Orgo2/insuDose/code/epaper_disp/OBJ/OLED.htm

# Static Call Graph for image ..\OBJ\OLED.axf

#<CALLGRAPH># ARM Linker, 5.03 [Build 76]: Last Updated: Fri May 08 14:31:21 2020

### Maximum Stack Usage = 680 bytes + Unknown(Functions without stacksize, Cycles, Untraceable Function Pointers)

### Call chain for Maximum Stack Depth:

__rt_entry_main ⇒ main ⇒ Paint_DrawNum ⇒ Paint_DrawString_EN ⇒ Paint_DrawChar ⇒ Paint_SetPixel

### Functions with no stack information

- __user_initial_stackheap

### Mutually Recursive functions

- ADC1_2_IRQHandler ⇒ ADC1_2_IRQHandler

### Function Pointers

- ADC1_2_IRQHandler from startup_stm32f10x_hd.o(.text) referenced from startup_stm32f10x_hd.o(RESET)
- ADC3_IRQHandler from startup_stm32f10x_hd.o(.text) referenced from startup_stm32f10x_hd.o(RESET)
- BusFault_Handler from stm32f10x_it.o(.text) referenced from startup_stm32f10x_hd.o(RESET)
- CAN1_RX1_IRQHandler from startup_stm32f10x_hd.o(.text) referenced from startup_stm32f10x_hd.o(RESET)
- CAN1_SCE_IRQHandler from startup_stm32f10x_hd.o(.text) referenced from startup_stm32f10x_hd.o(RESET)
- DMA1_Channel1_IRQHandler from startup_stm32f10x_hd.o(.text) referenced from startup_stm32f10x_hd.o(RESET)
- DMA1_Channel2_IRQHandler from startup_stm32f10x_hd.o(.text) referenced from startup_stm32f10x_hd.o(RESET)
- DMA1_Channel3_IRQHandler from startup_stm32f10x_hd.o(.text) referenced from startup_stm32f10x_hd.o(RESET)
- DMA1_Channel4_IRQHandler from startup_stm32f10x_hd.o(.text) referenced from startup_stm32f10x_hd.o(RESET)
- DMA1_Channel5_IRQHandler from startup_stm32f10x_hd.o(.text) referenced from startup_stm32f10x_hd.o(RESET)
- DMA1_Channel6_IRQHandler from startup_stm32f10x_hd.o(.text) referenced from startup_stm32f10x_hd.o(RESET)
- DMA1_Channel7_IRQHandler from startup_stm32f10x_hd.o(.text) referenced from startup_stm32f10x_hd.o(RESET)
- DMA2_Channel1_IRQHandler from startup_stm32f10x_hd.o(.text) referenced from startup_stm32f10x_hd.o(RESET)
- DMA2_Channel2_IRQHandler from startup_stm32f10x_hd.o(.text) referenced from startup_stm32f10x_hd.o(RESET)
- DMA2_Channel3_IRQHandler from startup_stm32f10x_hd.o(.text) referenced from startup_stm32f10x_hd.o(RESET)
- DMA2_Channel4_5_IRQHandler from startup_stm32f10x_hd.o(.text) referenced from startup_stm32f10x_hd.o(RESET)
- DebugMon_Handler from stm32f10x_it.o(.text) referenced from startup_stm32f10x_hd.o(RESET)
- EXTI0_IRQHandler from startup_stm32f10x_hd.o(.text) referenced from startup_stm32f10x_hd.o(RESET)
- EXTI15_10_IRQHandler from startup_stm32f10x_hd.o(.text) referenced from startup_stm32f10x_hd.o(RESET)
- EXTI1_IRQHandler from startup_stm32f10x_hd.o(.text) referenced from startup_stm32f10x_hd.o(RESET)
- EXTI2_IRQHandler from startup_stm32f10x_hd.o(.text) referenced from startup_stm32f10x_hd.o(RESET)
- EXTI3_IRQHandler from startup_stm32f10x_hd.o(.text) referenced from startup_stm32f10x_hd.o(RESET)
- EXTI4_IRQHandler from startup_stm32f10x_hd.o(.text) referenced from startup_stm32f10x_hd.o(RESET)
- EXTI9_5_IRQHandler from startup_stm32f10x_hd.o(.text) referenced from startup_stm32f10x_hd.o(RESET)
- FLASH_IRQHandler from startup_stm32f10x_hd.o(.text) referenced from startup_stm32f10x_hd.o(RESET)
- FSMC_IRQHandler from startup_stm32f10x_hd.o(.text) referenced from startup_stm32f10x_hd.o(RESET)
- HardFault_Handler from stm32f10x_it.o(.text) referenced from startup_stm32f10x_hd.o(RESET)
- I2C1_ER_IRQHandler from startup_stm32f10x_hd.o(.text) referenced from startup_stm32f10x_hd.o(RESET)
- I2C1_EV_IRQHandler from startup_stm32f10x_hd.o(.text) referenced from startup_stm32f10x_hd.o(RESET)
- I2C2_ER_IRQHandler from startup_stm32f10x_hd.o(.text) referenced from startup_stm32f10x_hd.o(RESET)
- I2C2_EV_IRQHandler from startup_stm32f10x_hd.o(.text) referenced from startup_stm32f10x_hd.o(RESET)
- MemManage_Handler from stm32f10x_it.o(.text) referenced from startup_stm32f10x_hd.o(RESET)
- NMI_Handler from stm32f10x_it.o(.text) referenced from startup_stm32f10x_hd.o(RESET)
- PVD_IRQHandler from startup_stm32f10x_hd.o(.text) referenced from startup_stm32f10x_hd.o(RESET)
- PendSV_Handler from stm32f10x_it.o(.text) referenced from startup_stm32f10x_hd.o(RESET)
- RCC_IRQHandler from startup_stm32f10x_hd.o(.text) referenced from startup_stm32f10x_hd.o(RESET)
- RTCAlarm_IRQHandler from startup_stm32f10x_hd.o(.text) referenced from startup_stm32f10x_hd.o(RESET)
- RTC_IRQHandler from startup_stm32f10x_hd.o(.text) referenced from startup_stm32f10x_hd.o(RESET)
- Reset_Handler from startup_stm32f10x_hd.o(.text) referenced from startup_stm32f10x_hd.o(RESET)
- SDIO_IRQHandler from startup_stm32f10x_hd.o(.text) referenced from startup_stm32f10x_hd.o(RESET)
- SPI1_IRQHandler from startup_stm32f10x_hd.o(.text) referenced from startup_stm32f10x_hd.o(RESET)
- SPI2_IRQHandler from startup_stm32f10x_hd.o(.text) referenced from startup_stm32f10x_hd.o(RESET)
- SPI3_IRQHandler from startup_stm32f10x_hd.o(.text) referenced from startup_stm32f10x_hd.o(RESET)
- SVC_Handler from stm32f10x_it.o(.text) referenced from startup_stm32f10x_hd.o(RESET)
- SysTick_Handler from stm32f10x_it.o(.text) referenced from startup_stm32f10x_hd.o(RESET)
- SystemInit from system_stm32f10x.o(.text) referenced from startup_stm32f10x_hd.o(.text)
- TAMPER_IRQHandler from startup_stm32f10x_hd.o(.text) referenced from startup_stm32f10x_hd.o(RESET)
- TIM1_BRK_IRQHandler from startup_stm32f10x_hd.o(.text) referenced from startup_stm32f10x_hd.o(RESET)
- TIM1_CC_IRQHandler from startup_stm32f10x_hd.o(.text) referenced from startup_stm32f10x_hd.o(RESET)
- TIM1_TRG_COM_IRQHandler from startup_stm32f10x_hd.o(.text) referenced from startup_stm32f10x_hd.o(RESET)
- TIM1_UP_IRQHandler from startup_stm32f10x_hd.o(.text) referenced from startup_stm32f10x_hd.o(RESET)
- TIM2_IRQHandler from startup_stm32f10x_hd.o(.text) referenced from startup_stm32f10x_hd.o(RESET)
- TIM3_IRQHandler from startup_stm32f10x_hd.o(.text) referenced from startup_stm32f10x_hd.o(RESET)
- TIM4_IRQHandler from startup_stm32f10x_hd.o(.text) referenced from startup_stm32f10x_hd.o(RESET)
- TIM5_IRQHandler from startup_stm32f10x_hd.o(.text) referenced from startup_stm32f10x_hd.o(RESET)
- TIM6_IRQHandler from startup_stm32f10x_hd.o(.text) referenced from startup_stm32f10x_hd.o(RESET)
- TIM7_IRQHandler from startup_stm32f10x_hd.o(.text) referenced from startup_stm32f10x_hd.o(RESET)
- TIM8_BRK_IRQHandler from startup_stm32f10x_hd.o(.text) referenced from startup_stm32f10x_hd.o(RESET)
- TIM8_CC_IRQHandler from startup_stm32f10x_hd.o(.text) referenced from startup_stm32f10x_hd.o(RESET)
- TIM8_TRG_COM_IRQHandler from startup_stm32f10x_hd.o(.text) referenced from startup_stm32f10x_hd.o(RESET)
- TIM8_UP_IRQHandler from startup_stm32f10x_hd.o(.text) referenced from startup_stm32f10x_hd.o(RESET)
- UART4_IRQHandler from startup_stm32f10x_hd.o(.text) referenced from startup_stm32f10x_hd.o(RESET)
- UART5_IRQHandler from startup_stm32f10x_hd.o(.text) referenced from startup_stm32f10x_hd.o(RESET)
- USART1_IRQHandler from usart.o(.text) referenced from startup_stm32f10x_hd.o(RESET)
- USART2_IRQHandler from startup_stm32f10x_hd.o(.text) referenced from startup_stm32f10x_hd.o(RESET)
- USART3_IRQHandler from startup_stm32f10x_hd.o(.text) referenced from startup_stm32f10x_hd.o(RESET)
- USBWakeUp_IRQHandler from startup_stm32f10x_hd.o(.text) referenced from startup_stm32f10x_hd.o(RESET)
- USB_HP_CAN1_TX_IRQHandler from startup_stm32f10x_hd.o(.text) referenced from startup_stm32f10x_hd.o(RESET)
- USB_LP_CAN1_RX0_IRQHandler from startup_stm32f10x_hd.o(.text) referenced from startup_stm32f10x_hd.o(RESET)
- UsageFault_Handler from stm32f10x_it.o(.text) referenced from startup_stm32f10x_hd.o(RESET)
- WWDG_IRQHandler from startup_stm32f10x_hd.o(.text) referenced from startup_stm32f10x_hd.o(RESET)
- __main from __main.o(!!!main) referenced from startup_stm32f10x_hd.o(.text)

### Global Symbols

__main (Thumb, 8 bytes, Stack size 0 bytes, __main.o(!!!main))

[Calls]

- >> __rt_entry
- >> __scatterload

__scatterload (Thumb, 0 bytes, Stack size unknown bytes, __scatter.o(!!!scatter))

[Called By]

- >> __main

__scatterload_rt2 (Thumb, 44 bytes, Stack size unknown bytes, __scatter.o(!!!scatter), UNUSED)

[Calls]

- >> __rt_entry

__scatterload_rt2_thumb_only (Thumb, 0 bytes, Stack size unknown bytes, __scatter.o(!!!scatter), UNUSED)

__scatterload_null (Thumb, 0 bytes, Stack size unknown bytes, __scatter.o(!!!scatter), UNUSED)

__scatterload_copy (Thumb, 26 bytes, Stack size unknown bytes, __scatter_copy.o(!!handler_copy), UNUSED)

[Calls]

- >> __scatterload_copy

[Called By]

- >> __scatterload_copy

__scatterload_zeroinit (Thumb, 28 bytes, Stack size unknown bytes, __scatter_zi.o(!!handler_zi), UNUSED)

__rt_lib_init (Thumb, 0 bytes, Stack size unknown bytes, libinit.o(.ARM.Collect$$libinit$$00000000))

[Called By]

- >> __rt_entry_li

__rt_lib_init_alloca_1 (Thumb, 0 bytes, Stack size unknown bytes, libinit2.o(.ARM.Collect$$libinit$$0000002C))

__rt_lib_init_argv_1 (Thumb, 0 bytes, Stack size unknown bytes, libinit2.o(.ARM.Collect$$libinit$$0000002A))

__rt_lib_init_atexit_1 (Thumb, 0 bytes, Stack size unknown bytes, libinit2.o(.ARM.Collect$$libinit$$00000019))

__rt_lib_init_clock_1 (Thumb, 0 bytes, Stack size unknown bytes, libinit2.o(.ARM.Collect$$libinit$$0000001F))

__rt_lib_init_cpp_1 (Thumb, 0 bytes, Stack size unknown bytes, libinit2.o(.ARM.Collect$$libinit$$00000030))

__rt_lib_init_exceptions_1 (Thumb, 0 bytes, Stack size unknown bytes, libinit2.o(.ARM.Collect$$libinit$$0000002E))

__rt_lib_init_fp_1 (Thumb, 0 bytes, Stack size unknown bytes, libinit2.o(.ARM.Collect$$libinit$$00000002))

__rt_lib_init_fp_trap_1 (Thumb, 0 bytes, Stack size unknown bytes, libinit2.o(.ARM.Collect$$libinit$$0000001D))

__rt_lib_init_getenv_1 (Thumb, 0 bytes, Stack size unknown bytes, libinit2.o(.ARM.Collect$$libinit$$00000021))

__rt_lib_init_heap_1 (Thumb, 0 bytes, Stack size unknown bytes, libinit2.o(.ARM.Collect$$libinit$$00000008))

__rt_lib_init_lc_collate_1 (Thumb, 0 bytes, Stack size unknown bytes, libinit2.o(.ARM.Collect$$libinit$$0000000F))

__rt_lib_init_lc_ctype_1 (Thumb, 0 bytes, Stack size unknown bytes, libinit2.o(.ARM.Collect$$libinit$$00000011))

__rt_lib_init_lc_monetary_1 (Thumb, 0 bytes, Stack size unknown bytes, libinit2.o(.ARM.Collect$$libinit$$00000013))

__rt_lib_init_lc_numeric_1 (Thumb, 0 bytes, Stack size unknown bytes, libinit2.o(.ARM.Collect$$libinit$$00000015))

__rt_lib_init_lc_time_1 (Thumb, 0 bytes, Stack size unknown bytes, libinit2.o(.ARM.Collect$$libinit$$00000017))

__rt_lib_init_rand_1 (Thumb, 0 bytes, Stack size unknown bytes, libinit2.o(.ARM.Collect$$libinit$$0000000C))

__rt_lib_init_return (Thumb, 0 bytes, Stack size unknown bytes, libinit2.o(.ARM.Collect$$libinit$$00000031))

__rt_lib_init_signal_1 (Thumb, 0 bytes, Stack size unknown bytes, libinit2.o(.ARM.Collect$$libinit$$0000001B))

__rt_lib_init_stdio_1 (Thumb, 0 bytes, Stack size unknown bytes, libinit2.o(.ARM.Collect$$libinit$$00000023))

__rt_lib_init_user_alloc_1 (Thumb, 0 bytes, Stack size unknown bytes, libinit2.o(.ARM.Collect$$libinit$$0000000A))

__rt_lib_shutdown (Thumb, 0 bytes, Stack size unknown bytes, libshutdown.o(.ARM.Collect$$libshutdown$$00000000))

[Called By]

- >> __rt_exit_ls

__rt_lib_shutdown_fp_trap_1 (Thumb, 0 bytes, Stack size unknown bytes, libshutdown2.o(.ARM.Collect$$libshutdown$$00000006))

__rt_lib_shutdown_heap_1 (Thumb, 0 bytes, Stack size unknown bytes, libshutdown2.o(.ARM.Collect$$libshutdown$$0000000E))

__rt_lib_shutdown_return (Thumb, 0 bytes, Stack size unknown bytes, libshutdown2.o(.ARM.Collect$$libshutdown$$0000000F))

__rt_lib_shutdown_signal_1 (Thumb, 0 bytes, Stack size unknown bytes, libshutdown2.o(.ARM.Collect$$libshutdown$$00000009))

__rt_lib_shutdown_stdio_1 (Thumb, 0 bytes, Stack size unknown bytes, libshutdown2.o(.ARM.Collect$$libshutdown$$00000003))

__rt_lib_shutdown_user_alloc_1 (Thumb, 0 bytes, Stack size unknown bytes, libshutdown2.o(.ARM.Collect$$libshutdown$$0000000B))

__rt_entry (Thumb, 0 bytes, Stack size unknown bytes, rtentry.o(.ARM.Collect$$rtentry$$00000000))

[Called By]

- >> __main
- >> __scatterload_rt2

__rt_entry_presh_1 (Thumb, 0 bytes, Stack size unknown bytes, rtentry2.o(.ARM.Collect$$rtentry$$00000002))

__rt_entry_sh (Thumb, 0 bytes, Stack size unknown bytes, rtentry4.o(.ARM.Collect$$rtentry$$00000004))

[Stack]

- Max Depth = 8 + Unknown Stack Size
- Call Chain = __rt_entry_sh ⇒ __user_setup_stackheap

[Calls]

- >> __user_setup_stackheap

__rt_entry_li (Thumb, 0 bytes, Stack size unknown bytes, rtentry2.o(.ARM.Collect$$rtentry$$0000000A))

[Calls]

- >> __rt_lib_init

__rt_entry_postsh_1 (Thumb, 0 bytes, Stack size unknown bytes, rtentry2.o(.ARM.Collect$$rtentry$$00000009))

__rt_entry_main (Thumb, 0 bytes, Stack size unknown bytes, rtentry2.o(.ARM.Collect$$rtentry$$0000000D))

[Stack]

- Max Depth = 680 + Unknown Stack Size
- Call Chain = __rt_entry_main ⇒ main ⇒ Paint_DrawNum ⇒ Paint_DrawString_EN ⇒ Paint_DrawChar ⇒ Paint_SetPixel

[Calls]

- >> exit
- >> main

__rt_entry_postli_1 (Thumb, 0 bytes, Stack size unknown bytes, rtentry2.o(.ARM.Collect$$rtentry$$0000000C))

__rt_exit (Thumb, 0 bytes, Stack size unknown bytes, rtexit.o(.ARM.Collect$$rtexit$$00000000))

[Called By]

- >> exit

__rt_exit_ls (Thumb, 0 bytes, Stack size unknown bytes, rtexit2.o(.ARM.Collect$$rtexit$$00000003))

[Calls]

- >> __rt_lib_shutdown

__rt_exit_prels_1 (Thumb, 0 bytes, Stack size unknown bytes, rtexit2.o(.ARM.Collect$$rtexit$$00000002))

__rt_exit_exit (Thumb, 0 bytes, Stack size unknown bytes, rtexit2.o(.ARM.Collect$$rtexit$$00000004))

[Calls]

- >> _sys_exit

main (Thumb, 576 bytes, Stack size 16 bytes, main.o(.text))

[Stack]

- Max Depth = 680
- Call Chain = main ⇒ Paint_DrawNum ⇒ Paint_DrawString_EN ⇒ Paint_DrawChar ⇒ Paint_SetPixel

[Calls]

- >> delay_s
- >> delay_init
- >> Paint_SelectImage
- >> Paint_NewImage
- >> Paint_DrawString_EN
- >> Paint_DrawRectangle
- >> Paint_DrawPoint
- >> Paint_DrawNum
- >> Paint_DrawLine
- >> Paint_DrawCircle
- >> Paint_Clear
- >> PIC_display_Clear
- >> PIC_display
- >> NVIC_Configuration
- >> EPD_sleep
- >> EPD_init
- >> EPD_GPIO_Init
- >> EPD_Display

[Called By]

- >> __rt_entry_main

NMI_Handler (Thumb, 2 bytes, Stack size 0 bytes, stm32f10x_it.o(.text))
[Address Reference Count : 1]

- startup_stm32f10x_hd.o(RESET)

HardFault_Handler (Thumb, 4 bytes, Stack size 0 bytes, stm32f10x_it.o(.text))
[Address Reference Count : 1]

- startup_stm32f10x_hd.o(RESET)

MemManage_Handler (Thumb, 4 bytes, Stack size 0 bytes, stm32f10x_it.o(.text))
[Address Reference Count : 1]

- startup_stm32f10x_hd.o(RESET)

BusFault_Handler (Thumb, 4 bytes, Stack size 0 bytes, stm32f10x_it.o(.text))
[Address Reference Count : 1]

- startup_stm32f10x_hd.o(RESET)

UsageFault_Handler (Thumb, 4 bytes, Stack size 0 bytes, stm32f10x_it.o(.text))
[Address Reference Count : 1]

- startup_stm32f10x_hd.o(RESET)

SVC_Handler (Thumb, 2 bytes, Stack size 0 bytes, stm32f10x_it.o(.text))
[Address Reference Count : 1]

- startup_stm32f10x_hd.o(RESET)

DebugMon_Handler (Thumb, 2 bytes, Stack size 0 bytes, stm32f10x_it.o(.text))
[Address Reference Count : 1]

- startup_stm32f10x_hd.o(RESET)

PendSV_Handler (Thumb, 2 bytes, Stack size 0 bytes, stm32f10x_it.o(.text))
[Address Reference Count : 1]

- startup_stm32f10x_hd.o(RESET)

SysTick_Handler (Thumb, 2 bytes, Stack size 0 bytes, stm32f10x_it.o(.text))
[Address Reference Count : 1]

- startup_stm32f10x_hd.o(RESET)

SystemInit (Thumb, 78 bytes, Stack size 8 bytes, system_stm32f10x.o(.text))

[Stack]

- Max Depth = 28
- Call Chain = SystemInit ⇒ SetSysClock ⇒ SetSysClockTo72

[Calls]

- >> SetSysClock

[Address Reference Count : 1]

- startup_stm32f10x_hd.o(.text)

SystemCoreClockUpdate (Thumb, 142 bytes, Stack size 8 bytes, system_stm32f10x.o(.text), UNUSED)

delay_init (Thumb, 50 bytes, Stack size 8 bytes, delay.o(.text))

[Stack]

- Max Depth = 8
- Call Chain = delay_init

[Calls]

- >> SysTick_CLKSourceConfig

[Called By]

- >> main

delay_us (Thumb, 70 bytes, Stack size 0 bytes, delay.o(.text), UNUSED)

delay_ms (Thumb, 70 bytes, Stack size 0 bytes, delay.o(.text))

[Called By]

- >> delay_s

delay_s (Thumb, 26 bytes, Stack size 12 bytes, delay.o(.text))

[Stack]

- Max Depth = 12
- Call Chain = delay_s

[Calls]

- >> delay_ms

[Called By]

- >> main

NVIC_Configuration (Thumb, 12 bytes, Stack size 8 bytes, sys.o(.text))

[Stack]

- Max Depth = 8
- Call Chain = NVIC_Configuration

[Calls]

- >> NVIC_PriorityGroupConfig

[Called By]

- >> main

_sys_exit (Thumb, 6 bytes, Stack size 0 bytes, usart.o(.text))

[Called By]

- >> __rt_exit_exit

fputc (Thumb, 22 bytes, Stack size 0 bytes, usart.o(.text), UNUSED)

uart_init (Thumb, 152 bytes, Stack size 32 bytes, usart.o(.text), UNUSED)

[Calls]

- >> USART_Init
- >> USART_ITConfig
- >> USART_Cmd
- >> RCC_APB2PeriphClockCmd
- >> NVIC_Init
- >> GPIO_Init

USART1_IRQHandler (Thumb, 122 bytes, Stack size 8 bytes, usart.o(.text))

[Stack]

- Max Depth = 24
- Call Chain = USART1_IRQHandler ⇒ USART_GetITStatus

[Calls]

- >> USART_ReceiveData
- >> USART_GetITStatus

[Address Reference Count : 1]

- startup_stm32f10x_hd.o(RESET)

Reset_Handler (Thumb, 8 bytes, Stack size 0 bytes, startup_stm32f10x_hd.o(.text))
[Address Reference Count : 1]

- startup_stm32f10x_hd.o(RESET)

ADC1_2_IRQHandler (Thumb, 0 bytes, Stack size 0 bytes, startup_stm32f10x_hd.o(.text))

[Calls]

- >> ADC1_2_IRQHandler

[Called By]

- >> ADC1_2_IRQHandler

[Address Reference Count : 1]

- startup_stm32f10x_hd.o(RESET)

ADC3_IRQHandler (Thumb, 0 bytes, Stack size 0 bytes, startup_stm32f10x_hd.o(.text))
[Address Reference Count : 1]

- startup_stm32f10x_hd.o(RESET)

CAN1_RX1_IRQHandler (Thumb, 0 bytes, Stack size 0 bytes, startup_stm32f10x_hd.o(.text))
[Address Reference Count : 1]

- startup_stm32f10x_hd.o(RESET)

CAN1_SCE_IRQHandler (Thumb, 0 bytes, Stack size 0 bytes, startup_stm32f10x_hd.o(.text))
[Address Reference Count : 1]

- startup_stm32f10x_hd.o(RESET)

DMA1_Channel1_IRQHandler (Thumb, 0 bytes, Stack size 0 bytes, startup_stm32f10x_hd.o(.text))
[Address Reference Count : 1]

- startup_stm32f10x_hd.o(RESET)

DMA1_Channel2_IRQHandler (Thumb, 0 bytes, Stack size 0 bytes, startup_stm32f10x_hd.o(.text))
[Address Reference Count : 1]

- startup_stm32f10x_hd.o(RESET)

DMA1_Channel3_IRQHandler (Thumb, 0 bytes, Stack size 0 bytes, startup_stm32f10x_hd.o(.text))
[Address Reference Count : 1]

- startup_stm32f10x_hd.o(RESET)

DMA1_Channel4_IRQHandler (Thumb, 0 bytes, Stack size 0 bytes, startup_stm32f10x_hd.o(.text))
[Address Reference Count : 1]

- startup_stm32f10x_hd.o(RESET)

DMA1_Channel5_IRQHandler (Thumb, 0 bytes, Stack size 0 bytes, startup_stm32f10x_hd.o(.text))
[Address Reference Count : 1]

- startup_stm32f10x_hd.o(RESET)

DMA1_Channel6_IRQHandler (Thumb, 0 bytes, Stack size 0 bytes, startup_stm32f10x_hd.o(.text))
[Address Reference Count : 1]

- startup_stm32f10x_hd.o(RESET)

DMA1_Channel7_IRQHandler (Thumb, 0 bytes, Stack size 0 bytes, startup_stm32f10x_hd.o(.text))
[Address Reference Count : 1]

- startup_stm32f10x_hd.o(RESET)

DMA2_Channel1_IRQHandler (Thumb, 0 bytes, Stack size 0 bytes, startup_stm32f10x_hd.o(.text))
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

- startup_stm32f10x_hd.o(RESET)

__user_initial_stackheap (Thumb, 0 bytes, Stack size unknown bytes, startup_stm32f10x_hd.o(.text))

[Called By]

- >> __user_setup_stackheap

NVIC_PriorityGroupConfig (Thumb, 10 bytes, Stack size 0 bytes, misc.o(.text))

[Called By]

- >> NVIC_Configuration

NVIC_Init (Thumb, 102 bytes, Stack size 16 bytes, misc.o(.text), UNUSED)

[Called By]

- >> uart_init

NVIC_SetVectorTable (Thumb, 14 bytes, Stack size 0 bytes, misc.o(.text), UNUSED)

NVIC_SystemLPConfig (Thumb, 34 bytes, Stack size 0 bytes, misc.o(.text), UNUSED)

SysTick_CLKSourceConfig (Thumb, 40 bytes, Stack size 0 bytes, misc.o(.text))

[Called By]

- >> delay_init

GPIO_DeInit (Thumb, 172 bytes, Stack size 8 bytes, stm32f10x_gpio.o(.text), UNUSED)

[Calls]

- >> RCC_APB2PeriphResetCmd

GPIO_AFIODeInit (Thumb, 20 bytes, Stack size 8 bytes, stm32f10x_gpio.o(.text), UNUSED)

[Calls]

- >> RCC_APB2PeriphResetCmd

GPIO_Init (Thumb, 274 bytes, Stack size 24 bytes, stm32f10x_gpio.o(.text))

[Stack]

- Max Depth = 24
- Call Chain = GPIO_Init

[Called By]

- >> uart_init
- >> EPD_GPIO_Init

GPIO_StructInit (Thumb, 16 bytes, Stack size 0 bytes, stm32f10x_gpio.o(.text), UNUSED)

GPIO_ReadInputDataBit (Thumb, 18 bytes, Stack size 0 bytes, stm32f10x_gpio.o(.text))

[Called By]

- >> lcd_chkstatus

GPIO_ReadInputData (Thumb, 8 bytes, Stack size 0 bytes, stm32f10x_gpio.o(.text), UNUSED)

GPIO_ReadOutputDataBit (Thumb, 18 bytes, Stack size 0 bytes, stm32f10x_gpio.o(.text), UNUSED)

GPIO_ReadOutputData (Thumb, 8 bytes, Stack size 0 bytes, stm32f10x_gpio.o(.text), UNUSED)

GPIO_SetBits (Thumb, 4 bytes, Stack size 0 bytes, stm32f10x_gpio.o(.text))

[Called By]

- >> SPI_Write
- >> EPD_W21_WriteDATA
- >> EPD_W21_WriteCMD
- >> EPD_W21_Init

GPIO_ResetBits (Thumb, 4 bytes, Stack size 0 bytes, stm32f10x_gpio.o(.text))

[Called By]

- >> SPI_Write
- >> EPD_W21_WriteDATA
- >> EPD_W21_WriteCMD
- >> EPD_W21_Init

GPIO_WriteBit (Thumb, 10 bytes, Stack size 0 bytes, stm32f10x_gpio.o(.text), UNUSED)

GPIO_Write (Thumb, 4 bytes, Stack size 0 bytes, stm32f10x_gpio.o(.text), UNUSED)

GPIO_PinLockConfig (Thumb, 18 bytes, Stack size 0 bytes, stm32f10x_gpio.o(.text), UNUSED)

GPIO_EventOutputConfig (Thumb, 26 bytes, Stack size 0 bytes, stm32f10x_gpio.o(.text), UNUSED)

GPIO_EventOutputCmd (Thumb, 6 bytes, Stack size 0 bytes, stm32f10x_gpio.o(.text), UNUSED)

GPIO_PinRemapConfig (Thumb, 138 bytes, Stack size 20 bytes, stm32f10x_gpio.o(.text), UNUSED)

GPIO_EXTILineConfig (Thumb, 66 bytes, Stack size 12 bytes, stm32f10x_gpio.o(.text), UNUSED)

GPIO_ETH_MediaInterfaceConfig (Thumb, 6 bytes, Stack size 0 bytes, stm32f10x_gpio.o(.text), UNUSED)

RCC_DeInit (Thumb, 64 bytes, Stack size 0 bytes, stm32f10x_rcc.o(.text), UNUSED)

RCC_HSEConfig (Thumb, 70 bytes, Stack size 0 bytes, stm32f10x_rcc.o(.text), UNUSED)

RCC_GetFlagStatus (Thumb, 56 bytes, Stack size 8 bytes, stm32f10x_rcc.o(.text), UNUSED)

[Called By]

- >> RCC_WaitForHSEStartUp

RCC_WaitForHSEStartUp (Thumb, 56 bytes, Stack size 16 bytes, stm32f10x_rcc.o(.text), UNUSED)

[Calls]

- >> RCC_GetFlagStatus

RCC_AdjustHSICalibrationValue (Thumb, 20 bytes, Stack size 0 bytes, stm32f10x_rcc.o(.text), UNUSED)

RCC_HSICmd (Thumb, 6 bytes, Stack size 0 bytes, stm32f10x_rcc.o(.text), UNUSED)

RCC_PLLConfig (Thumb, 24 bytes, Stack size 0 bytes, stm32f10x_rcc.o(.text), UNUSED)

RCC_PLLCmd (Thumb, 6 bytes, Stack size 0 bytes, stm32f10x_rcc.o(.text), UNUSED)

RCC_SYSCLKConfig (Thumb, 18 bytes, Stack size 0 bytes, stm32f10x_rcc.o(.text), UNUSED)

RCC_GetSYSCLKSource (Thumb, 10 bytes, Stack size 0 bytes, stm32f10x_rcc.o(.text), UNUSED)

RCC_HCLKConfig (Thumb, 18 bytes, Stack size 0 bytes, stm32f10x_rcc.o(.text), UNUSED)

RCC_PCLK1Config (Thumb, 18 bytes, Stack size 0 bytes, stm32f10x_rcc.o(.text), UNUSED)

RCC_PCLK2Config (Thumb, 20 bytes, Stack size 0 bytes, stm32f10x_rcc.o(.text), UNUSED)

RCC_ITConfig (Thumb, 26 bytes, Stack size 0 bytes, stm32f10x_rcc.o(.text), UNUSED)

RCC_USBCLKConfig (Thumb, 6 bytes, Stack size 0 bytes, stm32f10x_rcc.o(.text), UNUSED)

RCC_ADCCLKConfig (Thumb, 18 bytes, Stack size 0 bytes, stm32f10x_rcc.o(.text), UNUSED)

RCC_LSEConfig (Thumb, 44 bytes, Stack size 0 bytes, stm32f10x_rcc.o(.text), UNUSED)

RCC_LSICmd (Thumb, 6 bytes, Stack size 0 bytes, stm32f10x_rcc.o(.text), UNUSED)

RCC_RTCCLKConfig (Thumb, 12 bytes, Stack size 0 bytes, stm32f10x_rcc.o(.text), UNUSED)

RCC_RTCCLKCmd (Thumb, 8 bytes, Stack size 0 bytes, stm32f10x_rcc.o(.text), UNUSED)

RCC_GetClocksFreq (Thumb, 192 bytes, Stack size 12 bytes, stm32f10x_rcc.o(.text), UNUSED)

[Called By]

- >> USART_Init

RCC_AHBPeriphClockCmd (Thumb, 26 bytes, Stack size 0 bytes, stm32f10x_rcc.o(.text), UNUSED)

RCC_APB2PeriphClockCmd (Thumb, 26 bytes, Stack size 0 bytes, stm32f10x_rcc.o(.text))

[Called By]

- >> uart_init
- >> EPD_GPIO_Init

RCC_APB1PeriphClockCmd (Thumb, 26 bytes, Stack size 0 bytes, stm32f10x_rcc.o(.text), UNUSED)

RCC_APB2PeriphResetCmd (Thumb, 26 bytes, Stack size 0 bytes, stm32f10x_rcc.o(.text), UNUSED)

[Called By]

- >> USART_DeInit
- >> GPIO_AFIODeInit
- >> GPIO_DeInit

RCC_APB1PeriphResetCmd (Thumb, 26 bytes, Stack size 0 bytes, stm32f10x_rcc.o(.text), UNUSED)

[Called By]

- >> USART_DeInit

RCC_BackupResetCmd (Thumb, 8 bytes, Stack size 0 bytes, stm32f10x_rcc.o(.text), UNUSED)

RCC_ClockSecuritySystemCmd (Thumb, 6 bytes, Stack size 0 bytes, stm32f10x_rcc.o(.text), UNUSED)

RCC_MCOConfig (Thumb, 6 bytes, Stack size 0 bytes, stm32f10x_rcc.o(.text), UNUSED)

RCC_ClearFlag (Thumb, 14 bytes, Stack size 0 bytes, stm32f10x_rcc.o(.text), UNUSED)

RCC_GetITStatus (Thumb, 20 bytes, Stack size 0 bytes, stm32f10x_rcc.o(.text), UNUSED)

RCC_ClearITPendingBit (Thumb, 6 bytes, Stack size 0 bytes, stm32f10x_rcc.o(.text), UNUSED)

USART_DeInit (Thumb, 134 bytes, Stack size 8 bytes, stm32f10x_usart.o(.text), UNUSED)

[Calls]

- >> RCC_APB1PeriphResetCmd
- >> RCC_APB2PeriphResetCmd

USART_Init (Thumb, 210 bytes, Stack size 56 bytes, stm32f10x_usart.o(.text), UNUSED)

[Calls]

- >> RCC_GetClocksFreq

[Called By]

- >> uart_init

USART_StructInit (Thumb, 24 bytes, Stack size 0 bytes, stm32f10x_usart.o(.text), UNUSED)

USART_ClockInit (Thumb, 34 bytes, Stack size 8 bytes, stm32f10x_usart.o(.text), UNUSED)

USART_ClockStructInit (Thumb, 12 bytes, Stack size 0 bytes, stm32f10x_usart.o(.text), UNUSED)

USART_Cmd (Thumb, 24 bytes, Stack size 0 bytes, stm32f10x_usart.o(.text), UNUSED)

[Called By]

- >> uart_init

USART_ITConfig (Thumb, 74 bytes, Stack size 20 bytes, stm32f10x_usart.o(.text), UNUSED)

[Called By]

- >> uart_init

USART_DMACmd (Thumb, 18 bytes, Stack size 0 bytes, stm32f10x_usart.o(.text), UNUSED)

USART_SetAddress (Thumb, 18 bytes, Stack size 0 bytes, stm32f10x_usart.o(.text), UNUSED)

USART_WakeUpConfig (Thumb, 18 bytes, Stack size 0 bytes, stm32f10x_usart.o(.text), UNUSED)

USART_ReceiverWakeUpCmd (Thumb, 24 bytes, Stack size 0 bytes, stm32f10x_usart.o(.text), UNUSED)

USART_LINBreakDetectLengthConfig (Thumb, 18 bytes, Stack size 0 bytes, stm32f10x_usart.o(.text), UNUSED)

USART_LINCmd (Thumb, 24 bytes, Stack size 0 bytes, stm32f10x_usart.o(.text), UNUSED)

USART_SendData (Thumb, 8 bytes, Stack size 0 bytes, stm32f10x_usart.o(.text), UNUSED)

USART_ReceiveData (Thumb, 10 bytes, Stack size 0 bytes, stm32f10x_usart.o(.text))

[Called By]

- >> USART1_IRQHandler

USART_SendBreak (Thumb, 10 bytes, Stack size 0 bytes, stm32f10x_usart.o(.text), UNUSED)

USART_SetGuardTime (Thumb, 16 bytes, Stack size 0 bytes, stm32f10x_usart.o(.text), UNUSED)

USART_SetPrescaler (Thumb, 16 bytes, Stack size 0 bytes, stm32f10x_usart.o(.text), UNUSED)

USART_SmartCardCmd (Thumb, 24 bytes, Stack size 0 bytes, stm32f10x_usart.o(.text), UNUSED)

USART_SmartCardNACKCmd (Thumb, 24 bytes, Stack size 0 bytes, stm32f10x_usart.o(.text), UNUSED)

USART_HalfDuplexCmd (Thumb, 24 bytes, Stack size 0 bytes, stm32f10x_usart.o(.text), UNUSED)

USART_OverSampling8Cmd (Thumb, 22 bytes, Stack size 0 bytes, stm32f10x_usart.o(.text), UNUSED)

USART_OneBitMethodCmd (Thumb, 24 bytes, Stack size 0 bytes, stm32f10x_usart.o(.text), UNUSED)

USART_IrDAConfig (Thumb, 18 bytes, Stack size 0 bytes, stm32f10x_usart.o(.text), UNUSED)

USART_IrDACmd (Thumb, 24 bytes, Stack size 0 bytes, stm32f10x_usart.o(.text), UNUSED)

USART_GetFlagStatus (Thumb, 26 bytes, Stack size 0 bytes, stm32f10x_usart.o(.text), UNUSED)

USART_ClearFlag (Thumb, 18 bytes, Stack size 0 bytes, stm32f10x_usart.o(.text), UNUSED)

USART_GetITStatus (Thumb, 84 bytes, Stack size 16 bytes, stm32f10x_usart.o(.text))

[Stack]

- Max Depth = 16
- Call Chain = USART_GetITStatus

[Called By]

- >> USART1_IRQHandler

USART_ClearITPendingBit (Thumb, 52 bytes, Stack size 8 bytes, stm32f10x_usart.o(.text), UNUSED)

delay_xms (Thumb, 26 bytes, Stack size 0 bytes, display_epd_w21.o(.text))

[Called By]

- >> lcd_chkstatus
- >> EPD_W21_Init
- >> PIC_display_Clear
- >> PIC_display
- >> EPD_Display

EPD_W21_Init (Thumb, 36 bytes, Stack size 8 bytes, display_epd_w21.o(.text))

[Stack]

- Max Depth = 8
- Call Chain = EPD_W21_Init

[Calls]

- >> delay_xms
- >> GPIO_ResetBits
- >> GPIO_SetBits

[Called By]

- >> EPD_init

lcd_chkstatus (Thumb, 42 bytes, Stack size 8 bytes, display_epd_w21.o(.text))

[Stack]

- Max Depth = 32
- Call Chain = lcd_chkstatus ⇒ EPD_W21_WriteCMD ⇒ SPI_Write

[Calls]

- >> EPD_W21_WriteCMD
- >> delay_xms
- >> GPIO_ReadInputDataBit

[Called By]

- >> PIC_display_Clear
- >> PIC_display
- >> EPD_sleep
- >> EPD_init
- >> EPD_Display

EPD_Display (Thumb, 100 bytes, Stack size 24 bytes, display_epd_w21.o(.text))

[Stack]

- Max Depth = 56
- Call Chain = EPD_Display ⇒ lcd_chkstatus ⇒ EPD_W21_WriteCMD ⇒ SPI_Write

[Calls]

- >> EPD_W21_WriteDATA
- >> EPD_W21_WriteCMD
- >> lcd_chkstatus
- >> delay_xms

[Called By]

- >> main

EPD_init (Thumb, 96 bytes, Stack size 8 bytes, display_epd_w21.o(.text))

[Stack]

- Max Depth = 40
- Call Chain = EPD_init ⇒ lcd_chkstatus ⇒ EPD_W21_WriteCMD ⇒ SPI_Write

[Calls]

- >> EPD_W21_WriteDATA
- >> EPD_W21_WriteCMD
- >> lcd_chkstatus
- >> EPD_W21_Init

[Called By]

- >> main

EPD_sleep (Thumb, 38 bytes, Stack size 8 bytes, display_epd_w21.o(.text))

[Stack]

- Max Depth = 40
- Call Chain = EPD_sleep ⇒ lcd_chkstatus ⇒ EPD_W21_WriteCMD ⇒ SPI_Write

[Calls]

- >> EPD_W21_WriteDATA
- >> EPD_W21_WriteCMD
- >> lcd_chkstatus

[Called By]

- >> main

PIC_display (Thumb, 76 bytes, Stack size 16 bytes, display_epd_w21.o(.text))

[Stack]

- Max Depth = 48
- Call Chain = PIC_display ⇒ lcd_chkstatus ⇒ EPD_W21_WriteCMD ⇒ SPI_Write

[Calls]

- >> EPD_W21_WriteDATA
- >> EPD_W21_WriteCMD
- >> lcd_chkstatus
- >> delay_xms

[Called By]

- >> main

PIC_display_Clear (Thumb, 72 bytes, Stack size 8 bytes, display_epd_w21.o(.text))

[Stack]

- Max Depth = 40
- Call Chain = PIC_display_Clear ⇒ lcd_chkstatus ⇒ EPD_W21_WriteCMD ⇒ SPI_Write

[Calls]

- >> EPD_W21_WriteDATA
- >> EPD_W21_WriteCMD
- >> lcd_chkstatus
- >> delay_xms

[Called By]

- >> main

EPD_GPIO_Init (Thumb, 124 bytes, Stack size 8 bytes, display_epd_w21_spi.o(.text))

[Stack]

- Max Depth = 32
- Call Chain = EPD_GPIO_Init ⇒ GPIO_Init

[Calls]

- >> RCC_APB2PeriphClockCmd
- >> GPIO_Init

[Called By]

- >> main

SPI_Write (Thumb, 70 bytes, Stack size 16 bytes, display_epd_w21_spi.o(.text))

[Stack]

- Max Depth = 16
- Call Chain = SPI_Write

[Calls]

- >> GPIO_ResetBits
- >> GPIO_SetBits

[Called By]

- >> EPD_W21_WriteDATA
- >> EPD_W21_WriteCMD

EPD_W21_WriteCMD (Thumb, 42 bytes, Stack size 8 bytes, display_epd_w21_spi.o(.text))

[Stack]

- Max Depth = 24
- Call Chain = EPD_W21_WriteCMD ⇒ SPI_Write

[Calls]

- >> SPI_Write
- >> GPIO_ResetBits
- >> GPIO_SetBits

[Called By]

- >> lcd_chkstatus
- >> PIC_display_Clear
- >> PIC_display
- >> EPD_sleep
- >> EPD_init
- >> EPD_Display

EPD_W21_WriteDATA (Thumb, 42 bytes, Stack size 8 bytes, display_epd_w21_spi.o(.text))

[Stack]

- Max Depth = 24
- Call Chain = EPD_W21_WriteDATA ⇒ SPI_Write

[Calls]

- >> SPI_Write
- >> GPIO_ResetBits
- >> GPIO_SetBits

[Called By]

- >> PIC_display_Clear
- >> PIC_display
- >> EPD_sleep
- >> EPD_init
- >> EPD_Display

Paint_NewImage (Thumb, 122 bytes, Stack size 24 bytes, gui_paint.o(.text))

[Stack]

- Max Depth = 24
- Call Chain = Paint_NewImage

[Called By]

- >> main

Paint_SelectImage (Thumb, 6 bytes, Stack size 0 bytes, gui_paint.o(.text))

[Called By]

- >> main

Paint_SetRotate (Thumb, 22 bytes, Stack size 0 bytes, gui_paint.o(.text), UNUSED)

Paint_SetMirroring (Thumb, 20 bytes, Stack size 0 bytes, gui_paint.o(.text), UNUSED)

Paint_SetPixel (Thumb, 326 bytes, Stack size 24 bytes, gui_paint.o(.text))

[Stack]

- Max Depth = 24
- Call Chain = Paint_SetPixel

[Called By]

- >> Paint_DrawString_CN
- >> Paint_DrawChar
- >> Paint_ClearWindows
- >> Paint_DrawPoint

Paint_Clear (Thumb, 52 bytes, Stack size 12 bytes, gui_paint.o(.text))

[Stack]

- Max Depth = 12
- Call Chain = Paint_Clear

[Called By]

- >> main

Paint_ClearWindows (Thumb, 54 bytes, Stack size 32 bytes, gui_paint.o(.text), UNUSED)

[Calls]

- >> Paint_SetPixel

Paint_DrawPoint (Thumb, 164 bytes, Stack size 32 bytes, gui_paint.o(.text))

[Stack]

- Max Depth = 56
- Call Chain = Paint_DrawPoint ⇒ Paint_SetPixel

[Calls]

- >> Paint_SetPixel

[Called By]

- >> Paint_DrawLine
- >> Paint_DrawCircle
- >> main

Paint_DrawLine (Thumb, 252 bytes, Stack size 56 bytes, gui_paint.o(.text))

[Stack]

- Max Depth = 112
- Call Chain = Paint_DrawLine ⇒ Paint_DrawPoint ⇒ Paint_SetPixel

[Calls]

- >> Paint_DrawPoint

[Called By]

- >> Paint_DrawRectangle
- >> main

Paint_DrawRectangle (Thumb, 178 bytes, Stack size 48 bytes, gui_paint.o(.text))

[Stack]

- Max Depth = 160
- Call Chain = Paint_DrawRectangle ⇒ Paint_DrawLine ⇒ Paint_DrawPoint ⇒ Paint_SetPixel

[Calls]

- >> Paint_DrawLine

[Called By]

- >> main

Paint_DrawCircle (Thumb, 502 bytes, Stack size 40 bytes, gui_paint.o(.text))

[Stack]

- Max Depth = 96
- Call Chain = Paint_DrawCircle ⇒ Paint_DrawPoint ⇒ Paint_SetPixel

[Calls]

- >> Paint_DrawPoint

[Called By]

- >> main

Paint_DrawChar (Thumb, 266 bytes, Stack size 36 bytes, gui_paint.o(.text))

[Stack]

- Max Depth = 60
- Call Chain = Paint_DrawChar ⇒ Paint_SetPixel

[Calls]

- >> Paint_SetPixel

[Called By]

- >> Paint_DrawTime
- >> Paint_DrawString_EN

Paint_DrawString_EN (Thumb, 122 bytes, Stack size 44 bytes, gui_paint.o(.text))

[Stack]

- Max Depth = 104
- Call Chain = Paint_DrawString_EN ⇒ Paint_DrawChar ⇒ Paint_SetPixel

[Calls]

- >> Paint_DrawChar

[Called By]

- >> Paint_DrawNum
- >> main

Paint_DrawString_CN (Thumb, 530 bytes, Stack size 52 bytes, gui_paint.o(.text), UNUSED)

[Calls]

- >> Paint_SetPixel

Paint_DrawNum (Thumb, 158 bytes, Stack size 560 bytes, gui_paint.o(.text))

[Stack]

- Max Depth = 664
- Call Chain = Paint_DrawNum ⇒ Paint_DrawString_EN ⇒ Paint_DrawChar ⇒ Paint_SetPixel

[Calls]

- >> __aeabi_memclr4
- >> Paint_DrawString_EN

[Called By]

- >> main

Paint_DrawTime (Thumb, 360 bytes, Stack size 72 bytes, gui_paint.o(.text), UNUSED)

[Calls]

- >> Paint_DrawChar

Paint_DrawBitMap (Thumb, 56 bytes, Stack size 12 bytes, gui_paint.o(.text), UNUSED)

__use_no_semihosting (Thumb, 2 bytes, Stack size 0 bytes, use_no_semi_2.o(.text), UNUSED)

__aeabi_memclr4 (Thumb, 0 bytes, Stack size 4 bytes, rt_memclr_w.o(.text))

[Stack]

- Max Depth = 4
- Call Chain = __aeabi_memclr4

[Called By]

- >> Paint_DrawNum

__aeabi_memclr8 (Thumb, 0 bytes, Stack size 4 bytes, rt_memclr_w.o(.text), UNUSED)

__rt_memclr_w (Thumb, 78 bytes, Stack size 4 bytes, rt_memclr_w.o(.text), UNUSED)

_memset_w (Thumb, 0 bytes, Stack size unknown bytes, rt_memclr_w.o(.text), UNUSED)

__use_two_region_memory (Thumb, 2 bytes, Stack size 0 bytes, heapauxi.o(.text), UNUSED)

__rt_heap_escrow$2region (Thumb, 2 bytes, Stack size 0 bytes, heapauxi.o(.text), UNUSED)

__rt_heap_expand$2region (Thumb, 2 bytes, Stack size 0 bytes, heapauxi.o(.text), UNUSED)

__I$use$semihosting (Thumb, 0 bytes, Stack size 0 bytes, use_no_semi.o(.text), UNUSED)

__use_no_semihosting_swi (Thumb, 2 bytes, Stack size 0 bytes, use_no_semi.o(.text), UNUSED)

__user_setup_stackheap (Thumb, 74 bytes, Stack size 8 bytes, sys_stackheap_outer.o(.text))

[Stack]

- Max Depth = 8 + Unknown Stack Size
- Call Chain = __user_setup_stackheap

[Calls]

- >> __user_perproc_libspace
- >> __user_initial_stackheap

[Called By]

- >> __rt_entry_sh

exit (Thumb, 12 bytes, Stack size 0 bytes, exit.o(.text))

[Calls]

- >> __rt_exit

[Called By]

- >> __rt_entry_main

__user_libspace (Thumb, 8 bytes, Stack size 0 bytes, libspace.o(.text), UNUSED)

__user_perproc_libspace (Thumb, 0 bytes, Stack size 0 bytes, libspace.o(.text))

[Called By]

- >> __user_setup_stackheap

__user_perthread_libspace (Thumb, 0 bytes, Stack size 0 bytes, libspace.o(.text), UNUSED)

### Local Symbols

SetSysClockTo72 (Thumb, 212 bytes, Stack size 12 bytes, system_stm32f10x.o(.text))

[Stack]

- Max Depth = 12
- Call Chain = SetSysClockTo72

[Called By]

- >> SetSysClock

SetSysClock (Thumb, 8 bytes, Stack size 8 bytes, system_stm32f10x.o(.text))

[Stack]

- Max Depth = 20
- Call Chain = SetSysClock ⇒ SetSysClockTo72

[Calls]

- >> SetSysClockTo72

[Called By]

- >> SystemInit

### Undefined Global Symbols
