Orgo2/insuDose/InsuDos.pdf

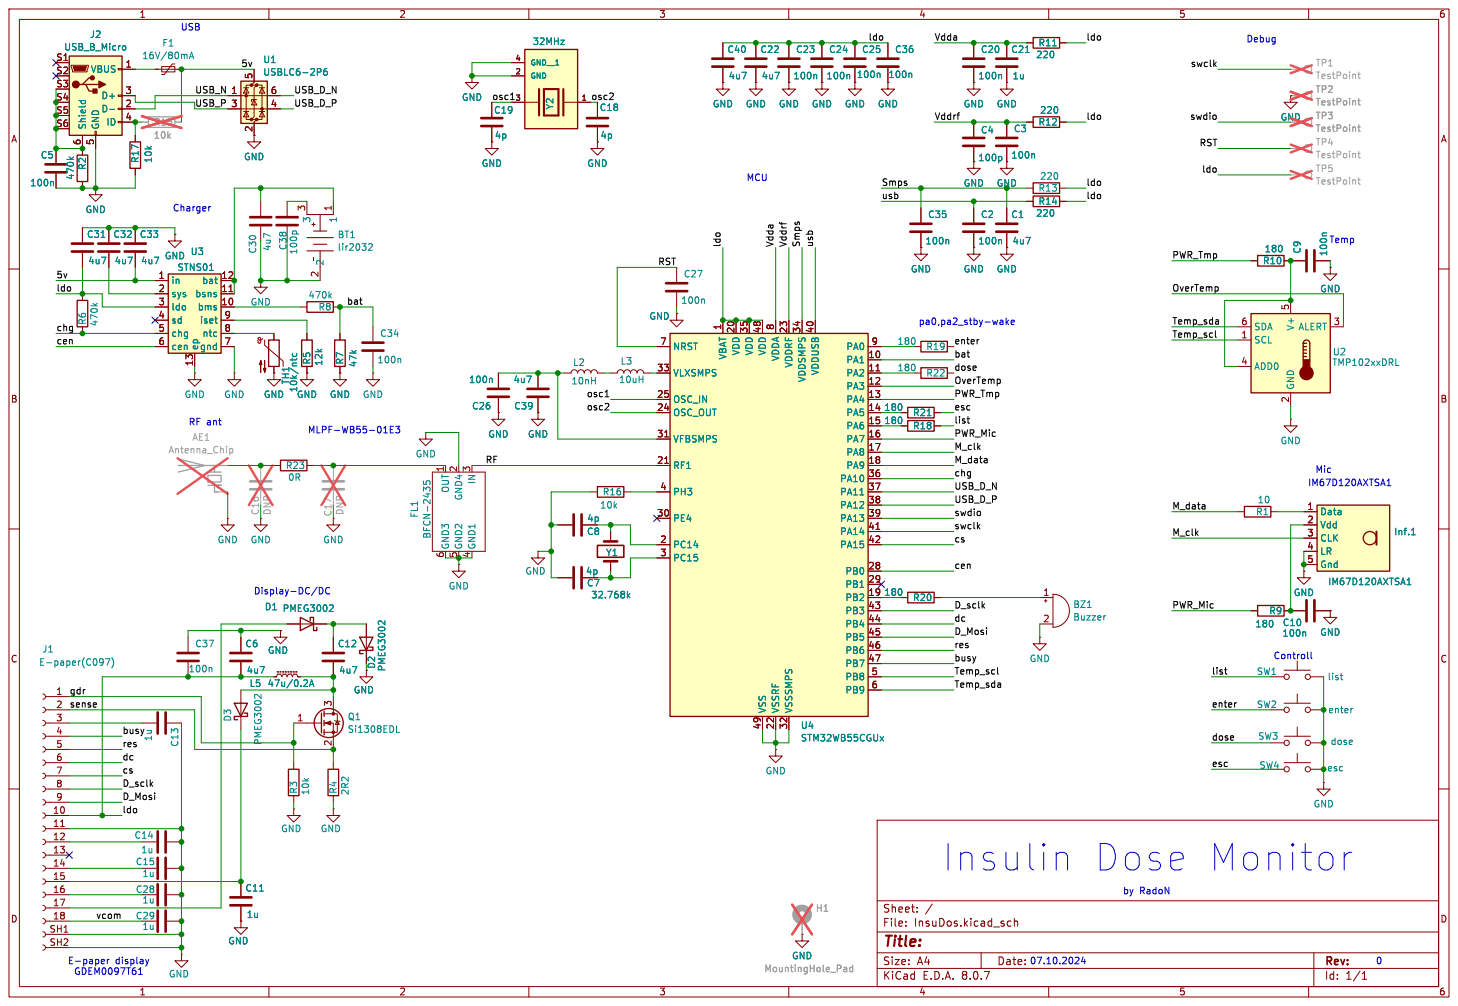
[picture p1: page 1]

8 PA0 9 GND C9 100n TP2 TestPoint GND TP3 TestPoint R10

busy D_Mosi res RF ant Charger

1 PA1 10 PA2 11 PA3 12 PA4 13 PA5 14 PA6 15 PA7 16 PA8 17 PA9 18 PB2 19 PC14 2 VDD 20 RF1 21 VSSRF 22 VDDRF 23 OSC_OUT 24 OSC_IN 25 PB0 28 PB1 29 PC15 3 PE4 30 VFBSMPS 31 VSSSMPS 32 VLXSMPS 33 VDDSMPS 34 VDD 35 PA10 36 PA11 37 PA12 38 PA13 39 PH3 4 VDDUSB 40 PA14 41 PA15 42 PB3 43 PB4 44 PB5 45 PB6 46 PB7 47 VDD 48 VSS 49 PB8 5 PB9 6 NRST 7 VDDA

list esc dose OverTemp
