Orgo2/insuDose/insuDoseV2/InsuDos.pdf

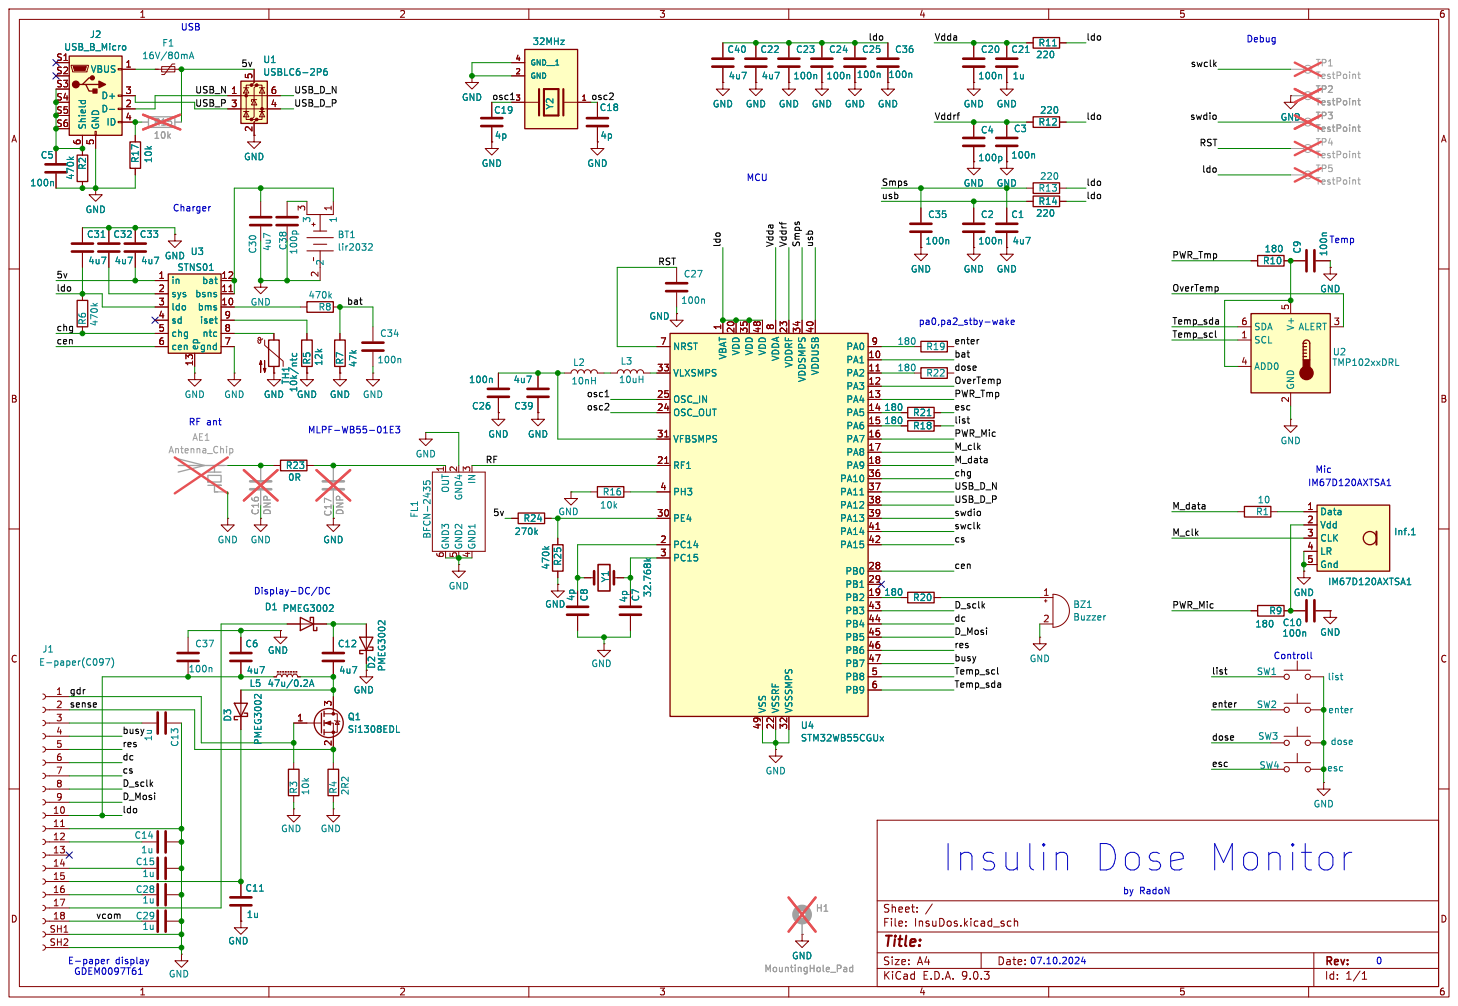
[picture p2: page 1]

ldo Vddrf RF Display-DC/DC

8 VSSRF 22 VDDRF 23 VSSSMPS 32 VDDSMPS 34 VDDUSB 40 PA0 9 PA1 10 PA2 11 PA3 12 PA4 13 PA5 14 PA6 15 PA7 16 PA8 17 PA9 18 PA10 36 PA11 37 PA12 38 PA13 39 PA14 41 PA15 42 PB0 28 PB1 29 PB2 19 PB3 43 PB4 44 PB5 45 PB6 46 PB7 47 PB8 5 PB9 6 U4STM32WB55CGUx R19 180R21 180 R22 180 R10
R18 180 H1 MountingHole_Pad

8 VSSRF 22 VDDRF 23 VSSSMPS 32 VDDSMPS 34 VDDUSB 40 PA0 9 PA1 10 PA2 11 PA3 12 PA4 13 PA5 14 PA6 15 PA7 16 PA8 17 PA9 18 PA10 36 PA11 37 PA12 38 PA13 39 PA14 41 PA15 42 PB0 28 PB1 29 PB2 19 PB3 43 PB4 44 PB5 45 PB6 46 PB7 47 PB8 5 PB9 6 R21 180 R10

1 VDD 20 VDD 35 VDD 48 VSS 49 VDDA
