Orgo2/insuDose/insuDoseV2/InsuDosV2.kicad_pcb

## KiCad design insuDoseV2/InsuDosV2.kicad_pcb (2025-11-01)

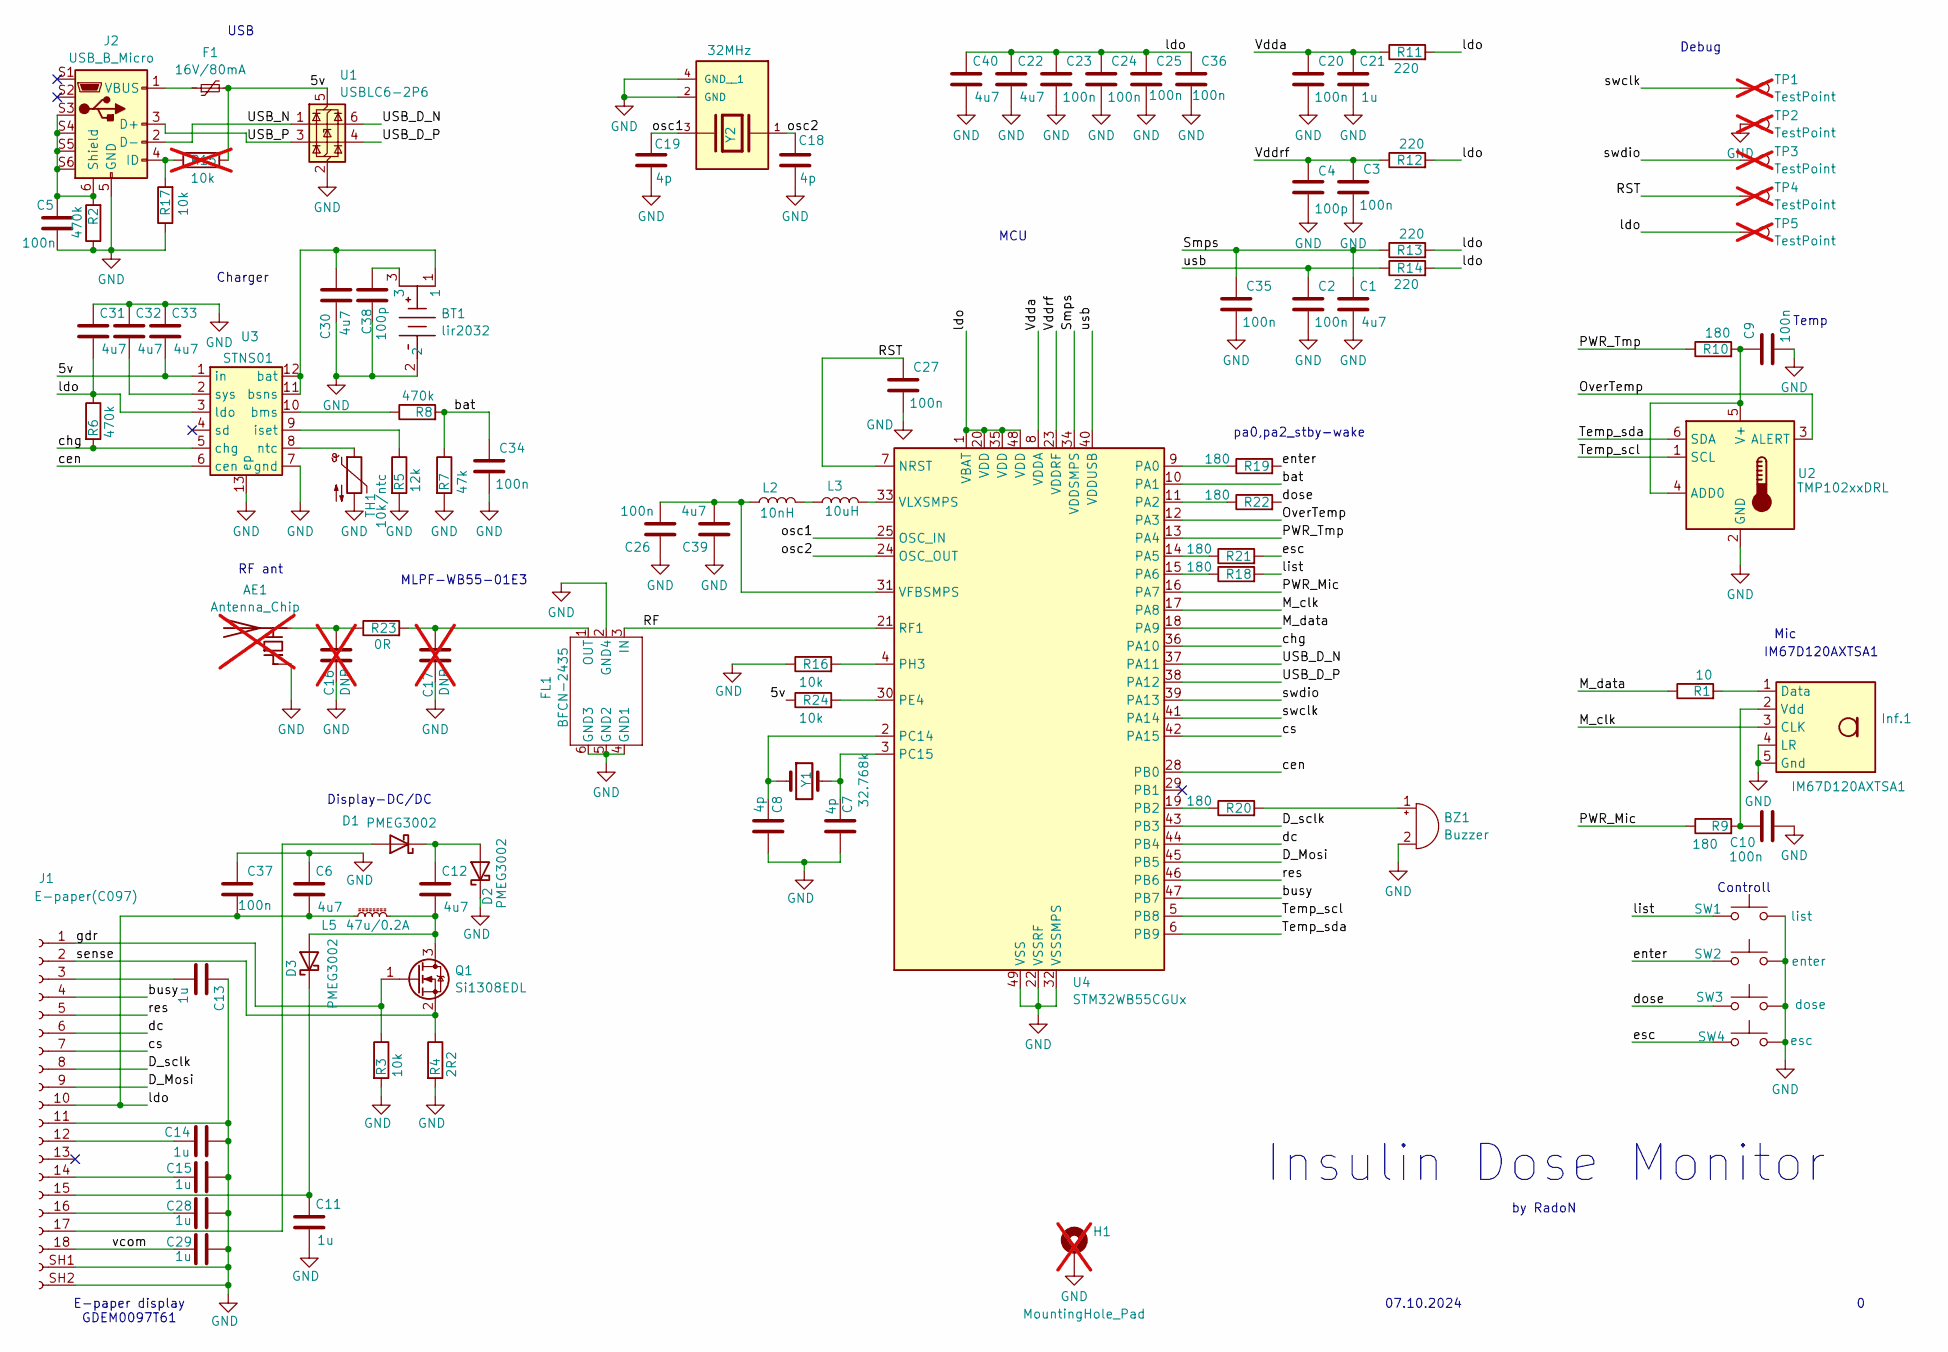
[picture p3: schematic InsuDosV2.kicad_sch]

Parts:
AE1: Antenna_Chip; Texas_SWRA117D_2.4GHz_Right; not fitted
BT1: lir2032; BATT_HLDR_via
BZ1: Buzzer; Buzzer_CUI_CPT-9019S-SMT
C1, C6, C12, C22, C30, C31, C32, C33, C39, C40: 4u7; C_0603_1608Metric
C2, C3, C5, C9, C10, C20, C23, C24, C25, C26, C27, C34, C35, C36, C37: 100n; C_0402_1005Metric
C4, C38: 100p; C_0402_1005Metric
C7, C8, C18, C19: 4p; C_0402_1005Metric
C11, C13, C14, C15, C21, C28, C29: 1u; C_0402_1005Metric
C16, C17: DNP; C_0402_1005Metric; not fitted
D1, D2, D3: PMEG3002; D_SOD-882
F1: 16V/80mA; Fuse_0603_1608Metric
FL1: BFCN-2435; St_filter
H1: MountingHole_Pad; MountingHole_2.2mm_M2_ISO14580_Pad_TopBottom; not fitted
Inf.1: IM67D120AXTSA1; Infineon_PG-LLGA-5-2
J1: E-paper(C097); MOLEX_503480-1800
J2: USB_B_Micro; AMPHENOL_10118193-0001LF
L2: 10nH; L_0402_1005Metric
L3: 10uH; L_0603_1608Metric
L5: 47u/0.2A; IND_TAIYO_BRC2016_TAY
Q1: Si1308EDL; SOT-323_SC-70
R1: 10; R_0402_1005Metric
R2, R6, R8: 470k; R_0402_1005Metric
R3, R16, R17, R24: 10k; R_0402_1005Metric
R4: 2R2; R_0402_1005Metric
R5: 12k; R_0402_1005Metric
R7: 47k; R_0402_1005Metric
R9, R10, R18, R19, R20, R21, R22: 180; R_0402_1005Metric
R11, R12, R13, R14: 220; R_0402_1005Metric
R15: 10k; R_0402_1005Metric; not fitted
R23: 0R; R_0402_1005Metric
SW1: list; SW_SPST_B3U-3100P-B
SW2: enter; SW_SPST_B3U-3100P-B
SW3: dose; SW_SPST_B3U-1100P-B
SW4: esc; SW_SPST_B3U-3100P-B
TH1: 10k/ntc; R_0402_1005Metric
TP1, TP2, TP3, TP4, TP5: TestPoint; TestPoint_Pad_1.0x1.0mm; not fitted
U1: USBLC6-2P6; SOT-666
U2: TMP102xxDRL; SOT-563
U3: STNS01; stns01
U4: STM32WB55CGUx; QFN-48-1EP_7x7mm_P0.5mm_EP5.6x5.6mm
Y1: 32.768k; Crystal_SMD_2012-2Pin_2.0x1.2mm
Y2: 32MHz; XTAL_ABM8W-32.0000MHZ-4-B1U-T3; PARTREV 08.09.2018

Connections:
/5v: C33.2, F1.2, R15.2, R24.1, U1.5 (VBUS), U3.1 (in)
/D_Mosi: J1.9, U4.45 (PB5)
/D_sclk: J1.8, U4.43 (PB3)
/M_clk: Inf.1.3 (CLK), U4.17 (PA8)
/M_data: R1.1, U4.18 (PA9)
/OverTemp: U2.3 (ALERT), U4.12 (PA3)
/PWR_Mic: R9.1, U4.16 (PA7)
/PWR_Tmp: R10.1, U4.13 (PA4)
/RF: FL1.3 (IN), U4.21 (RF1)
/RST: C27.1, TP4.1, U4.7 (NRST)
/Smps: C1.1, C35.1, R13.1, U4.34 (VDDSMPS)
/Temp_scl: U2.1 (SCL), U4.5 (PB8)
/Temp_sda: U2.6 (SDA), U4.6 (PB9)
/USB_D_N: U1.6 (I/O1), U4.37 (PA11)
/USB_D_P: U1.4 (I/O2), U4.38 (PA12)
/USB_N: J2.2 (D-), U1.1 (I/O1)
/USB_P: J2.3 (D+), U1.3 (I/O2)
/Vdda: C20.1, C21.1, R11.1, U4.8 (VDDA)
/Vddrf: C3.1, C4.1, R12.1, U4.23 (VDDRF)
/bat: C34.1, R7.1, R8.2, U4.10 (PA1)
/busy: J1.4, U4.47 (PB7)
/cen: U3.6 (cen), U4.28 (PB0)
/chg: R6.2, U3.5 (chg), U4.36 (PA10)
/cs: J1.7, U4.42 (PA15)
/dc: J1.6, U4.44 (PB4)
/dose: R22.2, SW3.2
/enter: R19.2, SW2.1
/esc: R21.2, SW4.2
/gdr: J1.1, Q1.1 (G), R3.1
/ldo: C6.2, C22.1, C23.1, C24.1, C25.1, C31.2, C36.1, C37.2, C40.1, J1.10, L5.1, R6.1, R11.2, R12.2, R13.2, R14.2, TP5.1, U3.3 (ldo), U4.1 (VBAT), U4.20 (VDD), U4.35 (VDD), U4.48 (VDD)
/list: R18.2, SW1.1
/osc1: C19.1, U4.25 (OSC_IN), Y2.3
/osc2: C18.1, U4.24 (OSC_OUT), Y2.1
/res: J1.5, U4.46 (PB6)
/sense: J1.2, Q1.2 (S), R4.1
/swclk: TP1.1, U4.41 (PA14)
/swdio: TP3.1, U4.39 (PA13)
/usb: C2.1, R14.1, U4.40 (VDDUSB)
/vcom: C29.2, J1.18
GND: AE1.2 (FEED), BT1.2, BZ1.2 (-), C1.2, C2.2, C3.2, C4.2, C5.2, C6.1, C7.1, C8.1, C9.2, C10.2, C11.2, C13.1, C14.1, C15.1, C16.2, C17.2, C18.2, C19.2, C20.2, C21.2, C22.2, C23.2, C24.2, C25.2, C26.1, C27.2, C28.1, C29.1, C30.2, C31.1, C32.1, C33.1, C34.2, C35.2, C36.2, C37.1, C38.1, C39.1, C40.2, D2.1 (K), FL1.2 (GND4), FL1.4 (GND1), FL1.5 (GND2), FL1.6 (GND3), H1.1, Inf.1.4 (LR), Inf.1.5 (Gnd), J1.11, J1.SH1, J1.SH2, J2.5 (GND), R2.1, R3.2, R4.2, R5.2, R7.2, R16.1, R17.1, SW1.2, SW1.3, SW2.2, SW2.3, SW3.1, SW3.3, SW4.1, SW4.3, TH1.2, TP2.1, U1.2 (GND), U2.2 (GND), U3.7 (gnd), U3.13 (ep), U4.22 (VSSRF), U4.32 (VSSSMPS), U4.49 (VSS), Y2.2 (GND), Y2.4 (GND__1)
unnamed: AE1.1 (PCB_Trace), C16.1, R23.1
unnamed: BT1.3, C38.2
unnamed: BZ1.1 (+), R20.2
unnamed: D1.2 (A), J1.17
unnamed: C12.1, D1.1 (K), D2.2 (A)
unnamed: C12.2, D3.2 (A), L5.2, Q1.3 (D)
unnamed: C11.1, D3.1 (K), J1.15
unnamed: C17.1, FL1.1 (OUT), R23.2
unnamed: Inf.1.1 (Data), R1.2
unnamed: C10.1, Inf.1.2 (Vdd), R9.2
unnamed: C13.2, J1.3
unnamed: C14.2, J1.12
unnamed: C15.2, J1.14
unnamed: C28.2, J1.16
unnamed: J2.4 (ID), R15.1, R17.2
unnamed: C5.1, J2.6 (Shield), J2.S3, J2.S4, J2.S5, J2.S6, R2.2
unnamed: F1.1, J2.1 (VBUS)
unnamed: L2.2, L3.1
unnamed: R24.2, U4.30 (PE4)
unnamed: C9.1, R10.2, U2.4 (ADD0), U2.5 (V+)
unnamed: BT1.1, C30.1, U3.11 (bsns), U3.12 (bat)
unnamed: R8.1, U3.10 (bms)
unnamed: R5.1, U3.9 (iset)
unnamed: TH1.1, U3.8 (ntc)
unnamed: C32.2, U3.2 (sys)
unnamed: R19.1, U4.9 (PA0)
unnamed: R22.1, U4.11 (PA2)
unnamed: R21.1, U4.14 (PA5)
unnamed: R18.1, U4.15 (PA6)
unnamed: R20.1, U4.19 (PB2)
unnamed: C8.2, U4.2 (PC14), Y1.1
unnamed: C7.2, U4.3 (PC15), Y1.2
unnamed: R16.2, U4.4 (PH3)
unnamed: C26.2, C39.2, L2.1, U4.31 (VFBSMPS)
unnamed: L3.2, U4.33 (VLXSMPS)

Notes on the sheet:
Insulin Dose Monitor
USB
Mic
Temp
pa0,pa2_stby-wake
RF ant
Controll
IM67D120AXTSA1
07.10.2024
Display-DC/DC
E-paper display GDEM0097T61
Debug
Charger
by RadoN
MCU
MLPF-WB55-01E3

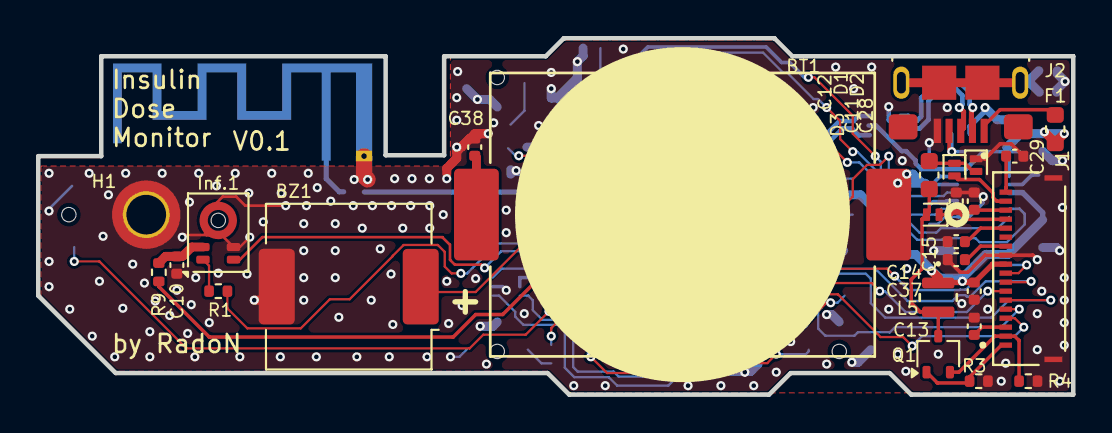
[picture p4: board InsuDosV2.kicad_pcb from above]

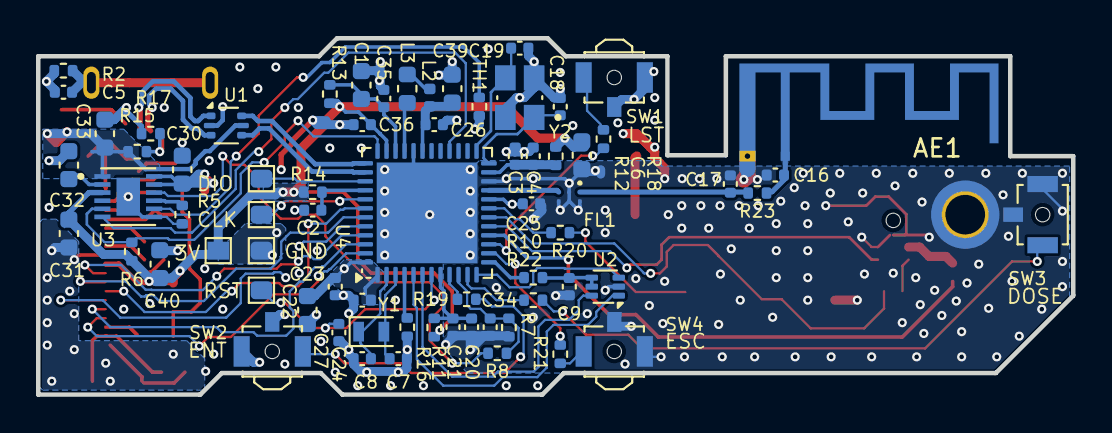
[picture p5: board InsuDosV2.kicad_pcb from below]

Board: 4 copper layers, 57.5 x 19.8 mm, 95 parts (69 on the bottom side), 74 nets.
