Orgo2/insuDose/code/epd_ssd1680/ascii_8x12.c

#include "ascii_8x12.h"

// Example font for 'A' only
const uint8_t font8x12[96][12] = {
    [33] = { 0x00,0x18,0x3C,0x3C,0x3C,0x18,0x18,0x00,0x18,0x00,0x00,0x00 }, // !
    [65-32] = { 0x00,0x18,0x3C,0x24,0x66,0x66,0x7E,0x66,0x66,0x00,0x00,0x00 }, // A
    // Add rest of ASCII chars if needed
};
