Orgo2/insuDose/firmware_tests/Insudose/Insudose.ioc

Mcu.UserName=STM32WB55CGUx
PA0.GPIO_Label=ENT
PA0.Signal=GPXTI0
PA1.GPIO_Label=BATT
PA1.Signal=ADCx_IN6
PA10.Signal=SAI1_D1
PA11.Signal=USB_DM
PA12.Signal=USB_DP
PA13.Signal=SYS_JTMS-SWDIO
PA14.Signal=SYS_JTCK-SWCLK
PA15.GPIO_Label=D_CS
PA15.Signal=GPIO_Output
PA2.GPIO_Label=DOSE
PA2.Signal=GPXTI2
PA3.Signal=SAI1_CK1
PA4.GPIO_Label=PW_TMP
PA4.Signal=GPIO_Output
PA5.GPIO_Label=ESC
PA5.Signal=GPIO_Input
PA6.GPIO_Label=LIST
PA6.Signal=GPIO_Input
PA7.GPIO_Label=PW_MIC
PA7.Signal=GPIO_Output
PA8.Signal=SAI1_CK2
PA9.Signal=SAI1_D2
PB0.GPIO_Label=CEN
PB0.Signal=GPIO_Input
PB2.GPIO_Label=BUZZ
PB2.Signal=LPTIM1_OUT
PB3.GPIO_Label=D_SCLK
PB3.Signal=GPIO_Output
PB4.GPIO_Label=D_DC
PB4.Signal=GPIO_Output
PB5.GPIO_Label=D_MOSI
PB5.Signal=GPIO_Output
PB6.GPIO_Label=D_RST
PB6.Signal=GPIO_Output
PB7.GPIO_Label=D_BUSY
PB7.Signal=GPIO_Input
PB8.Signal=I2C1_SCL
PB9.Signal=I2C1_SDA
PC14-OSC32_IN.Signal=RCC_OSC32_IN
PC15-OSC32_OUT.Signal=RCC_OSC32_OUT
PE4.GPIO_Label=USB_I
PE4.Signal=GPXTI4
