Orgo2/insuDose/firmware_tests/Insudose/Core/Src/main.c

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
/* Includes ------------------------------------------------------------------*/
#include "main.h"
#include "adc.h"
#include "app_fatfs.h"
#include "i2c.h"
#include "ipcc.h"
#include "lptim.h"
#include "rf.h"
#include "rtc.h"
#include "sai.h"
#include "usb_device.h"
#include "gpio.h"

/* USER CODE BEGIN Includes */
#include "Display_EPD_W21_spi.h"
#include "Display_EPD_W21.h"
#include "fonts.h"
#include "GUI_Paint.h"
#include <string.h>
#include "stdio.h"
#include "tmp102.h"
#include "logger.h"
#include "charger.h"
#include "../../Drivers/Boot/bootload.h"
#define ENABLE_EPD 0
/* USER CODE END Includes */

/* USER CODE BEGIN PTD */
#define BUTTON_PIN GPIO_PIN_0
#define BUTTON_PORT GPIOA
#define PIEZO_PIN GPIO_PIN_2
#define PIEZO_PORT GPIOB
#define Butt_TIMEOUT_MS 2000

/* USER CODE END PTD */

/* USER CODE BEGIN PD */
extern RTC_HandleTypeDef hrtc;
//LPTIM_HandleTypeDef hlptim1;

/* USER CODE END PD */


/* USER CODE BEGIN PV */
//static uint8_t BlackImage[EPD_WIDTH * EPD_HEIGHT / 8]; //display drawing buffer
static uint8_t BlackImage[EPD_WIDTH * EPD_HEIGHT / 8];
static uint8_t epd_inited = 0;
uint8_t dose = 0;
float temperature = 0.0f;
static volatile uint8_t dose_event_pending = 0;
static volatile uint8_t usb_event_pending = 0; // edge detected on USB 5V pin
static uint8_t usb_connected = 0; // tracked state
static uint8_t usb_started = 0;   // whether USB device stack is started

// Generic debounce utility (shared for future buttons)
typedef struct {
  uint8_t stable_level;     // last stable raw level (0/1)
  uint8_t debounced_state;  // last debounced logical state (0=not pressed,1=pressed)
  uint32_t last_toggle_ms;  // last time raw changed
  uint32_t debounce_ms;     // threshold
  uint8_t active_low;       // invert logic
} DebounceCtx;

static uint8_t debounce_update(DebounceCtx *ctx, uint8_t raw_level, uint32_t now_ms)
{
  uint8_t event = 0; // 1=pressed, 2=released
  if (raw_level != ctx->stable_level) {
    if ((now_ms - ctx->last_toggle_ms) >= ctx->debounce_ms) {
      // accept new stable level
      ctx->stable_level = raw_level;
      ctx->last_toggle_ms = now_ms;
      uint8_t logical = ctx->active_low ? (ctx->stable_level == 0) : (ctx->stable_level == 1);
      if (logical != ctx->debounced_state) {
        ctx->debounced_state = logical;
        event = logical ? 1 : 2;
      }
    }
  } else {
    // no change; refresh timer baseline
    ctx->last_toggle_ms = now_ms;
  }
  return event;
}

static DebounceCtx s_db_dose = { .stable_level = 1, .debounced_state = 0, .last_toggle_ms = 0, .debounce_ms = 30, .active_low = 1 };
static uint8_t usb_boot_check_active = 0; // non-blocking bootloader hold in progress
static uint32_t usb_boot_deadline_ms = 0;  // time when we decide about boot jump
volatile uint32_t g_boot_stage = 0;        // diagnostic marker for bring-up
/* USER CODE END PV */

void SystemClock_Config(void);
void PeriphCommonClock_Config(void);
/* USER CODE BEGIN PFP */
void PlayBeep(uint32_t duration_ms);
static void BeepPattern(uint8_t count, uint32_t on_ms, uint32_t off_ms);
//void RTC_SetBuildTime(void);
//void Check_And_Log(void);
/* USER CODE END PFP */

/* USER CODE BEGIN 0 */
// removed extra helper prototypes; logic is inlined in main loop
/* USER CODE END 0 */

/**
  * @brief  The application entry point.
  * @retval int
  */
int main(void)
{

  /* MCU Configuration--------------------------------------------------------*/

  /* Reset of all peripherals, Initializes the Flash interface and the Systick. */
  HAL_Init();
  /* Config code for STM32_WPAN (HSE Tuning must be done before system clock configuration) */
  MX_APPE_Config();

  /* Configure the system clock */
  SystemClock_Config();

  /* Configure the peripherals common clocks */
  PeriphCommonClock_Config();

  /* IPCC initialisation */
  MX_IPCC_Init();

  /* Initialize all configured peripherals */
  MX_GPIO_Init();
  MX_LPTIM1_Init();
  PlayBeep(20);
  MX_RTC_Init();
  MX_I2C1_Init();
  MX_LPTIM2_Init();
  MX_ADC1_Init();
  MX_SAI1_Init();
  if (MX_FATFS_Init() != APP_OK) {
    Error_Handler();
  }
  MX_USB_Device_Init();
  MX_RF_Init();
  /* USER CODE BEGIN 2 */
  // Initialize peripherals for sensors & display
#if ENABLE_EPD
  EPD_GPIO_Init();
  EPD_HW_Init();
  epd_inited = 1;
#endif
  HAL_GPIO_WritePin(PW_TMP_GPIO_Port, PW_TMP_Pin, GPIO_PIN_SET); // power temperature sensor
  HAL_Delay(5);
  TMP102_Init(&hi2c1);
  init_ramdisk();

  // Charger config for CR2032: disable charging, set low-battery thresholds
  charger_set_enabled(false);
  charger_batt_watchdog_config(2700, 200, 100); // sleep=2.7V, hyst=0.2V, watchdog band=0.1V

  // Read USB sense pin only for state tracking; do not gate USB start by this pin.
  usb_connected = (HAL_GPIO_ReadPin(USB_I_GPIO_Port, USB_I_Pin) == GPIO_PIN_SET);
  if (!usb_started) {
    // Diagnostic mode: always start USB stack to validate host enumeration path.
    USB_Device_Start();
    usb_started = 1;
  }
  // If ENTER is held at startup, schedule bootloader jump after 5s (non-blocking).
  if (HAL_GPIO_ReadPin(ENT_GPIO_Port, ENT_Pin) == GPIO_PIN_RESET) {
    usb_boot_check_active = 1;
    usb_boot_deadline_ms = HAL_GetTick() + 5000u;
  }
  g_boot_stage = 8;
  logger_set_usb_active(usb_connected);
  /* USER CODE END 2 */

  /* Init code for STM32_WPAN */
  MX_APPE_Init();
  g_boot_stage = 9;

  // Audible marker: app reached runtime loop.
  BeepPattern(1, 30, 0);

  /* Infinite loop */
  /* USER CODE BEGIN WHILE */
  while (1)
  {
    MX_APPE_Process();
    /* USER CODE BEGIN WHILE */
    // removed old dose_event_pending handler; DOSE is handled by debounce below
    if (usb_event_pending) {
      usb_event_pending = 0;
      uint8_t vbus_now = (HAL_GPIO_ReadPin(USB_I_GPIO_Port, USB_I_Pin) == GPIO_PIN_SET);
      if (vbus_now && !usb_started) {
        // Start USB immediately
        USB_Device_Start();
        usb_started = 1;
      }
      usb_connected = vbus_now;
      logger_set_usb_active(usb_connected);
    }

    // Handle deferred bootloader decision.
    if (usb_boot_check_active) {
      if ((int32_t)(HAL_GetTick() - usb_boot_deadline_ms) >= 0) {
        BeepPattern(2, 30, 40);
        JumpToBootloader();
        usb_boot_check_active = 0; // in case jump returns
      } else if (HAL_GPIO_ReadPin(ENT_GPIO_Port, ENT_Pin) != GPIO_PIN_RESET) {
        // Released early -> cancel bootloader request
        usb_boot_check_active = 0;
      }
    }

    // Debounce DOSE and act on PRESS event
    uint8_t dose_event = debounce_update(&s_db_dose, (HAL_GPIO_ReadPin(DOSE_GPIO_Port, DOSE_Pin) == GPIO_PIN_SET) ? 1 : 0, HAL_GetTick());
    if (dose_event == 1) { // pressed
      RTC_TimeTypeDef sTime; RTC_DateTypeDef sDate;
      HAL_RTC_GetTime(&hrtc, &sTime, RTC_FORMAT_BIN);
      HAL_RTC_GetDate(&hrtc, &sDate, RTC_FORMAT_BIN);
      uint16_t yearFull = 2000u + sDate.Year;
      uint8_t mon = sDate.Month;
      uint8_t day = sDate.Date;
      uint8_t hour = sTime.Hours;
      uint8_t min = sTime.Minutes;
      float temp_f = 0.0f;
      int8_t temp_i = LOG_NO_TEMP;
      if (TMP102_ReadTemperature(&hi2c1, &temp_f) == HAL_OK) {
        temp_i = (int8_t)(temp_f + (temp_f >= 0 ? 0.5f : -0.5f));
      }
      uint8_t dose_units = 1; // fixed per request
      append_log_rotating(yearFull, mon, day, hour, min, dose_units, temp_i);
      CHARGER_Fast fast = charger_get_fast();
#if ENABLE_EPD
      if (!epd_inited) { EPD_GPIO_Init(); EPD_HW_Init(); epd_inited = 1; }
      char dateStr[16];
      char timeStr[16];
      char tempStr[16];
      char battStr[20];
      char chgStr[12];
      snprintf(dateStr, sizeof(dateStr), "%02u.%02u.%04u", (unsigned)day, (unsigned)mon, (unsigned)yearFull);
      snprintf(timeStr, sizeof(timeStr), "%02u:%02u", (unsigned)hour, (unsigned)min);
      if (temp_i == (int8_t)LOG_NO_TEMP) snprintf(tempStr, sizeof(tempStr), "T: /"); else snprintf(tempStr, sizeof(tempStr), "T: %dC", temp_i);
      if (fast.batt_mv > 0) snprintf(battStr, sizeof(battStr), "Bat: %ldmV", (long)fast.batt_mv); else snprintf(battStr, sizeof(battStr), "Bat: /");
      switch (fast.status) {
        case CHARGER_STATUS_CHARGING: strcpy(chgStr, "CHG"); break;
        case CHARGER_STATUS_IDLE: strcpy(chgStr, "IDLE"); break;
        case CHARGER_STATUS_FAULT: strcpy(chgStr, "FLT"); break;
        default: strcpy(chgStr, "?"); break;
      }
      Paint_NewImage(BlackImage, EPD_WIDTH, EPD_HEIGHT, ROTATE_90, WHITE);
      Paint_SetMirroring(MIRROR_VERTICAL);
      Paint_Clear(WHITE);
      Paint_DrawString_EN(5, 5, dateStr, &Font16, WHITE, BLACK);
      Paint_DrawString_EN(5, 30, timeStr, &Font24, WHITE, BLACK);
      Paint_DrawString_EN(5, 60, tempStr, &Font16, WHITE, BLACK);
      Paint_DrawString_EN(5, 80, battStr, &Font16, WHITE, BLACK);
      Paint_DrawString_EN(5, 100, chgStr, &Font16, WHITE, BLACK);
      EPD_Display(BlackImage);
#endif
      PlayBeep(100);
    }
    __WFI(); // inline idle sleep
    /* USER CODE END WHILE */
    MX_APPE_Process();

    /* USER CODE BEGIN 3 */
  }
  /* USER CODE END 3 */
}

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
/* USER CODE BEGIN 4 */
/////////////////this function generates acoustic signal on mcu GPIO pin via LPTIM//////////////////////
void PlayBeep(uint32_t duration_ms) {
    uint32_t lptim_clk_hz = HAL_RCCEx_GetPeriphCLKFreq(RCC_PERIPHCLK_LPTIM1);
    uint32_t target_hz = 4000u;
    uint32_t ticks_per_period;
    uint32_t period;
    uint32_t pulse;

    if (duration_ms == 0u) {
      return;
    }
    if (duration_ms > 100u) {
      duration_ms = 100u;
    }

    if (lptim_clk_hz == 0u) {
      // Safe fallback if clock query is unavailable.
      lptim_clk_hz = 4000000u;
    }

    ticks_per_period = lptim_clk_hz / target_hz;
    if (ticks_per_period < 2u) {
      ticks_per_period = 2u;
    } else if (ticks_per_period > 0xFFFFu) {
      ticks_per_period = 0xFFFFu;
    }

    period = ticks_per_period - 1u;
    pulse = ticks_per_period / 2u;
    if (pulse == 0u) {
      pulse = 1u;
    }

    if (HAL_LPTIM_PWM_Start(&hlptim1, period, pulse) == HAL_OK) {
      HAL_Delay(duration_ms);
      (void)HAL_LPTIM_PWM_Stop(&hlptim1);
    }
}

static void BeepPattern(uint8_t count, uint32_t on_ms, uint32_t off_ms)
{
  for (uint8_t i = 0; i < count; i++) {
    PlayBeep(on_ms);
    if ((off_ms > 0u) && (i + 1u < count)) {
      HAL_Delay(off_ms);
    }
  }
}

/////////////////set build time function//////////////////////
void RTC_SetBuildTime(void) {
    RTC_TimeTypeDef sTime = {0};
    RTC_DateTypeDef sDate = {0};

    // Parse __DATE__ "Apr 28 2025"
    char build_date[] = __DATE__;
    char build_time[] = __TIME__;

    // Mesiace
    const char *months[] = {
        "Jan", "Feb", "Mar", "Apr", "May", "Jun",
        "Jul", "Aug", "Sep", "Oct", "Nov", "Dec"
    };

    int month = 0;
    for (int i = 0; i < 12; i++) {
        if (strncmp(build_date, months[i], 3) == 0) {
            month = i + 1;
            break;
        }
    }

    int day, year, hour, minute, second;
    sscanf(build_date + 4, "%d %d", &day, &year);
    sscanf(build_time, "%d:%d:%d", &hour, &minute, &second);

    sDate.Year = year % 100; // RTC chce len posledné 2 číslice
    sDate.Month = month;
    sDate.Date = day;
    sDate.WeekDay = 1; // Ignorujeme, HAL to nastaví sám

    sTime.Hours = hour;
    sTime.Minutes = minute;
    sTime.Seconds = second;
    sTime.DayLightSaving = RTC_DAYLIGHTSAVING_NONE;
    sTime.StoreOperation = RTC_STOREOPERATION_RESET;

    HAL_RTC_SetTime(&hrtc, &sTime, RTC_FORMAT_BIN);
    HAL_RTC_SetDate(&hrtc, &sDate, RTC_FORMAT_BIN);
}
///////////////////end of buildtime function////////////////////////

//////////////////datalogger function////////////////////
/*
void Check_And_Log(void)
{
    static uint8_t last_button_state = 1;
    static uint32_t last_debounce_time = 0;
    const uint32_t debounce_delay = 50; // 50 ms debounce

    uint8_t current_state = HAL_GPIO_ReadPin(GPIOA, GPIO_PIN_5);

    if (current_state != last_button_state)
    {
        last_debounce_time = HAL_GetTick(); // reset debounce timer
    }

    if ((HAL_GetTick() - last_debounce_time) > debounce_delay)
    {
        if (current_state == GPIO_PIN_RESET) // tlačidlo stlačené (aktívny stav)
        {
            dose = 5;  // Tu si môžeš dynamicky nastaviť dávku ako potrebuješ

            int8_t temp_int = (int8_t)(temperature + 0.5f); // zaokrúhlenie floatu na najbližšie celé číslo

            Log_SaveRecord(dose, temp_int);
        }
    }

    last_button_state = current_state;
}
*/
/////////////////////////////end of datalogger function//////////////////////

// EXTI events: mark pending flags for main loop processing
void HAL_GPIO_EXTI_Callback(uint16_t GPIO_Pin) {
  if (GPIO_Pin == DOSE_Pin) {
    dose_event_pending = 1;
  } else if (GPIO_Pin == USB_I_Pin) {
    usb_event_pending = 1;
  }
}
/* USER CODE END 4 */
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
