Orgo2/insuDose/firmware_tests/usb/Core/Src/main.c

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
/* Includes ------------------------------------------------------------------*/
#include "main.h"
#include "app_fatfs.h"
#include "usb_device.h"

/* USER CODE BEGIN Includes */
#include "app_runtime.h"
/* main.c keeps CubeMX-generated peripheral bring-up; app_runtime.c owns the application flow. */
/* USER CODE END Includes */

ADC_HandleTypeDef hadc1;

CRC_HandleTypeDef hcrc;

I2C_HandleTypeDef hi2c1;

LPTIM_HandleTypeDef hlptim1;

RTC_HandleTypeDef hrtc;

SAI_HandleTypeDef hsai_BlockA1;
DMA_HandleTypeDef hdma_sai1_a;

void SystemClock_Config(void);
void PeriphCommonClock_Config(void);
static void MX_GPIO_Init(void);
static void MX_DMA_Init(void);
static void MX_LPTIM1_Init(void);
static void MX_ADC1_Init(void);
static void MX_RTC_Init(void);
static void MX_I2C1_Init(void);
static void MX_SAI1_Init(void);
static void MX_CRC_Init(void);
/**
  * @brief  The application entry point.
  * @retval int
  */
int main(void)
{

  /* MCU Configuration--------------------------------------------------------*/

  /* Reset of all peripherals, Initializes the Flash interface and the Systick. */
  HAL_Init();

  /* Configure the system clock */
  SystemClock_Config();

  /* Configure the peripherals common clocks */
  PeriphCommonClock_Config();

  /* Initialize all configured peripherals */
  MX_GPIO_Init();
  MX_DMA_Init();
  MX_LPTIM1_Init();
  if (MX_FATFS_Init() != APP_OK) {
    Error_Handler();
  }
  MX_ADC1_Init();
  MX_RTC_Init();
  MX_I2C1_Init();
  MX_SAI1_Init();
  MX_CRC_Init();
  /* USER CODE BEGIN 2 */
  /* Hand control to the higher-level runtime once all HAL handles exist. */
  if (!app_runtime_init(&hi2c1, &hlptim1)) {
    Error_Handler();
  }
  /* USER CODE END 2 */

  /* Infinite loop */
  /* USER CODE BEGIN WHILE */
  while (1)
  {
    /* USER CODE END WHILE */

    /* USER CODE BEGIN 3 */
    /* The application is organized as one cooperative superloop tick. */
    app_runtime_tick();
  }
  /* USER CODE END 3 */
}

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
/* USER CODE BEGIN 4 */
/* Hardware callbacks are forwarded to app_runtime so policy stays out of generated code. */
void HAL_RTCEx_WakeUpTimerEventCallback(RTC_HandleTypeDef *rtc)
{
  (void)rtc;
  app_runtime_on_rtc_wakeup();
}

void HAL_GPIO_EXTI_Callback(uint16_t GPIO_Pin)
{
  app_runtime_on_exti(GPIO_Pin);
}

void HAL_PWR_PVDCallback(void)
{
  app_runtime_on_pvd();
}

void HAL_PWREx_PVD_PVMCallback(PWR_PVMTypeDef PVD_PVM)
{
  (void)PVD_PVM;
  app_runtime_on_pvd();
}

/* USER CODE END 4 */
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
