Orgo2/insuDose/firmware_tests/MEMS_test/Core/Src/main.c

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
/* Includes ------------------------------------------------------------------*/
#include "main.h"

DFSDM_Filter_HandleTypeDef hdfsdm1_filter0;
DFSDM_Channel_HandleTypeDef hdfsdm1_channel2;
DMA_HandleTypeDef hdma_dfsdm1_flt0;

UART_HandleTypeDef huart1;
DMA_HandleTypeDef hdma_usart1_tx;

/* USER CODE BEGIN PV */
#define AUDIO_BUF 1024 //amount of budder samples
int i = 0;
int butt = 0;//gpio status storage
int32_t RecBuff [AUDIO_BUF]; //pdm data buffer
int32_t PlayBuff [AUDIO_BUF];//PCM data buffer
uint32_t DmaRecHalfBuffCplt =0;//mic halfdata sent
uint32_t DmaRecBuffCplt = 0;//mic transfer finished
int32_t trigger = (1u << 31)-1u;


/* USER CODE END PV */

void SystemClock_Config(void);
static void MX_GPIO_Init(void);
static void MX_DMA_Init(void);
static void MX_DFSDM1_Init(void);
static void MX_USART1_UART_Init(void);
/* USER CODE BEGIN 0 */
//funkcia na posielanie dat cez uart
void UART_DMA_Transmit(int32_t* pBuffer, uint16_t size)
{
    // Čakáme na dokončenie predchádzajúceho prenosu
    if (HAL_UART_GetState(&huart1) != HAL_UART_STATE_READY)
    {
        return;  // UART nie je pripravený, môže byť ešte aktívny iný prenos
    }

    // Spustenie prenosu cez DMA
    if (HAL_UART_Transmit_DMA(&huart1, (uint8_t*)pBuffer, size * sizeof(int32_t)) != HAL_OK)
    {
        Error_Handler(); // Funkcia na spracovanie chýb
    }
}



//void UART_Transmit(int32_t data) {
//	char buffer[4];
//	for (size_t i = 0; i < 4; ++i) {
//		buffer[0] = (data >> 24) & 0xFF;
//		buffer[1] = (data >> 16) & 0xFF;
//		buffer[2] = (data >> 8) & 0xFF;
//		buffer[3] = data & 0xFF;
//		HAL_UART_Transmit(&huart1, buffer[i], 4, HAL_MAX_DELAY);
		//HAL_Delay(1);
//		}
//	}
/* USER CODE END 0 */

/**
  * @brief  The application entry point.
  * @retval int
  */
int main(void)
{

  /* MCU Configuration--------------------------------------------------------*/

  /* Reset of all peripherals, Initializes the Flash interface and the Systick. */
  HAL_Init();

  /* Configure the system clock */
  SystemClock_Config();

  /* Initialize all configured peripherals */
  MX_GPIO_Init();
  MX_DMA_Init();
  MX_DFSDM1_Init();
  MX_USART1_UART_Init();
  /* USER CODE BEGIN 2 */
  HAL_DFSDM_FilterRegularStart_DMA (&hdfsdm1_filter0, (int32_t*) RecBuff, AUDIO_BUF);
  HAL_UART_Transmit_DMA(&huart1, (uint8_t*)PlayBuff, sizeof(PlayBuff));
  /* USER CODE END 2 */

  /* Infinite loop */
  /* USER CODE BEGIN WHILE */
  while (1)
  {
    /* USER CODE END WHILE */

    /* USER CODE BEGIN 3 */



	 		if (DmaRecHalfBuffCplt == 1) //processing of the first half of the buffer
	 		{
	 	  /*
	 	  Store values on Play buff */
	 		  for( i = 0; i < AUDIO_BUF/2; i++){
	 			  PlayBuff[i] = RecBuff [i] >> 8;//example of PCM data postprocessing
	 		  	  DmaRecHalfBuffCplt  = 0;
	 		  	  // Spustenie prenosu cez DMA pre prvú polovicu bufferu
	 		  	  HAL_UART_Transmit_DMA(&huart1, (uint8_t*)PlayBuff, (AUDIO_BUF/2) * sizeof(int32_t));
	 		  }
	 		}
	 		if (DmaRecBuffCplt == 1)//processing of the second half of the buffer
	 		{
	 			/* Store values on Play buff */
	 		  for( i = AUDIO_BUF/2; i < AUDIO_BUF; i++){
	 			  PlayBuff [i] = RecBuff [i] >> 8;//example of PCM data postprocessing
	 			  DmaRecBuffCplt  = 0;
	 			  ///prenos dat pre druhu polovicu
	 			  HAL_UART_Transmit_DMA(&huart1, (uint8_t*)PlayBuff, (AUDIO_BUF/2) * sizeof(int32_t));
	 			  }
	 		 HAL_UART_Transmit_DMA(&huart1, (uint8_t*)trigger, (1) * sizeof(int32_t));
	}

//	 HAL_GPIO_WritePin(GPIOB, GPIO_PIN_14, GPIO_PIN_RESET);


  }
  /* USER CODE END 3 */
}

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
/* USER CODE BEGIN 4 */
void
HAL_DFSDM_FilterRegConvHalfCpltCallback (DFSDM_Filter_HandleTypeDef *hdfsdm_filter)
{
DmaRecHalfBuffCplt = 1;
}
void
HAL_DFSDM_FilterRegConvCpltCallback (DFSDM_Filter_HandleTypeDef *hdfsdm_filter)
{
DmaRecBuffCplt = 1;
}
/* USER CODE END 4 */
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
