Orgo2/insuDose/firmware_tests/Insudose/Drivers/TMP102/tmp102.c

#include "tmp102.h"
#include "gpio.h"
#include <math.h>

#define TMP102_I2C_TIMEOUT_MS 20U

// Helper: convert Celsius to TMP102 12-bit register bytes (MSB, LSB)
static void tmp102_conv_temp_to_bytes(float temp_c, uint8_t *out_msb, uint8_t *out_lsb)
{
    int16_t temp_raw = (int16_t)roundf(temp_c * 16.0f);
    uint16_t raw12 = (uint16_t)temp_raw & 0x0FFF;
    *out_msb = (uint8_t)(raw12 >> 4);
    *out_lsb = (uint8_t)((raw12 & 0x0F) << 4);
}


// Inicializácia TMP102 (voliteľné, môžeš nakonfigurovať režimy ak chceš)
HAL_StatusTypeDef TMP102_Init(I2C_HandleTypeDef *hi2c)
{
	// Ensure internal pull-ups are ON for I2C pins while sensor is active
	if (!hi2c || hi2c->Instance != I2C1) return HAL_ERROR;
	    GPIO_InitTypeDef GPIO_InitStruct = {0};
	    __HAL_RCC_GPIOB_CLK_ENABLE();
	    GPIO_InitStruct.Pin = GPIO_PIN_8 | GPIO_PIN_9; // SCL / SDA
	    GPIO_InitStruct.Mode = GPIO_MODE_AF_OD;
	    GPIO_InitStruct.Pull = GPIO_PULLUP;           // INTERNAL PULLUPS ENABLED
	    GPIO_InitStruct.Speed = GPIO_SPEED_FREQ_LOW;
	    GPIO_InitStruct.Alternate = GPIO_AF4_I2C1;
	    HAL_GPIO_Init(GPIOB, &GPIO_InitStruct);
	// 1) Zapni napájanie senzora cez definovaný pin PW_TMP
	HAL_GPIO_WritePin(PW_TMP_GPIO_Port, PW_TMP_Pin, GPIO_PIN_SET);

	// 2) Počkajúci čas na stabilizáciu senzora (typicky 250 ms)
	HAL_Delay(250);
	if (HAL_I2C_IsDeviceReady(hi2c, TMP102_I2C_ADDRESS, 2, TMP102_I2C_TIMEOUT_MS) != HAL_OK) {
		return HAL_ERROR;
	}
	// TMP102 je pripravený ihneď po napájaní.
    // Voliteľne by si mohol nastaviť konfiguráciu, ale default je OK.
    return HAL_OK;
}

//deinicializacia(vypnutie) TMP102 senzora
void TMP102_Deinit()
{
	HAL_GPIO_WritePin(PW_TMP_GPIO_Port, PW_TMP_Pin, GPIO_PIN_RESET);
	HAL_Delay(100);
	// disable (set to analog no-pull) for lowest leakage when sensor off
	GPIO_InitTypeDef GPIO_InitStruct = {0};
	GPIO_InitStruct.Pin = GPIO_PIN_8 | GPIO_PIN_9;
	GPIO_InitStruct.Mode = GPIO_MODE_ANALOG;
	GPIO_InitStruct.Pull = GPIO_NOPULL;
	HAL_GPIO_Init(GPIOB, &GPIO_InitStruct);
	// TMP102_DisableBusPullups(&hi2c1);
}

// Čítanie teploty
HAL_StatusTypeDef TMP102_ReadTemperature(I2C_HandleTypeDef *hi2c, float *temperature_celsius)
{
    uint8_t buffer[2];
    uint8_t reg_pointer = 0x00; // Pointer na Temperature Register
    HAL_StatusTypeDef ret;

    if ((hi2c == NULL) || (temperature_celsius == NULL)) {
        return HAL_ERROR;
    }

    // Nastav pointer na temperature register
    ret = HAL_I2C_Master_Transmit(hi2c, TMP102_I2C_ADDRESS, &reg_pointer, 1, TMP102_I2C_TIMEOUT_MS);
    if (ret != HAL_OK) {
        return ret;
    }

    // Prečítaj 2 bajty
    ret = HAL_I2C_Master_Receive(hi2c, TMP102_I2C_ADDRESS, buffer, 2, TMP102_I2C_TIMEOUT_MS);
    if (ret != HAL_OK) {
        return ret;
    }


    // Spracovanie údajov
    uint16_t raw_temp = (buffer[0] << 4) | (buffer[1] >> 4);

    // Ak je teplota záporná, rozšíriť znamienko
    if (raw_temp & 0x800) {
        raw_temp |= 0xF000;
    }

    // Prevod na °C
    *temperature_celsius = raw_temp * 0.0625f;

    return HAL_OK;
}



// Nastaví oba prahy (T_LOW a T_HIGH) a konfiguruje TMP102 do comparator režimu
// s nízkou spotrebou. Funkcia zapne napájanie cez PW_TMP pin, počká na štart
// senzora, zapíše T_LOW a T_HIGH a nastaví konfiguráciu.
HAL_StatusTypeDef TMP102_SetAlarm(I2C_HandleTypeDef *hi2c, float t_low_c, float t_high_c, uint8_t fault_count)
{
    if (hi2c == NULL) {
        return HAL_ERROR;
    }

    // Basic validation: t_low must be strictly less than t_high
    if (t_low_c >= t_high_c) {
        return HAL_ERROR;
    }

    // Clamp temperatures to TMP102 valid range (typical datasheet: -55 to +128 °C)
    if (t_low_c < -55.0f) t_low_c = -55.0f;
    if (t_high_c > 128.0f) t_high_c = 128.0f;

    HAL_StatusTypeDef ret;

    // 1) Zapni napájanie senzora cez definovaný pin PW_TMP
    HAL_GPIO_WritePin(PW_TMP_GPIO_Port, PW_TMP_Pin, GPIO_PIN_SET);

    // 2) Počkajúci čas na stabilizáciu senzora (typicky 250 ms)
    HAL_Delay(250);
    if (HAL_I2C_IsDeviceReady(hi2c, TMP102_I2C_ADDRESS, 2, TMP102_I2C_TIMEOUT_MS) != HAL_OK) {
        return HAL_ERROR;
    }

    // 3) Zapiš T_LOW
    uint8_t tx_low[3];
    tx_low[0] = TMP102_REG_T_LOW;
    tmp102_conv_temp_to_bytes(t_low_c, &tx_low[1], &tx_low[2]);

    ret = HAL_I2C_Master_Transmit(hi2c, TMP102_I2C_ADDRESS, tx_low, 3, TMP102_I2C_TIMEOUT_MS);
    if (ret != HAL_OK) {
        return ret;
    }

    // 5) Zapiš T_HIGH
    uint8_t tx_high[3];
    tx_high[0] = TMP102_REG_T_HIGH;
    tmp102_conv_temp_to_bytes(t_high_c, &tx_high[1], &tx_high[2]);

    ret = HAL_I2C_Master_Transmit(hi2c, TMP102_I2C_ADDRESS, tx_high, 3, TMP102_I2C_TIMEOUT_MS);
    if (ret != HAL_OK) {
        return ret;
    }

    // 6) Priprav konfiguraciu
    // Mapovanie fault_count -> F1 F0: 1->00, 2->01, 4->10, 6->11. Default = 4.
    uint8_t f1 = 1;
    uint8_t f0 = 0;
    if (fault_count == 1) { f1 = 0; f0 = 0; }
    else if (fault_count == 2) { f1 = 0; f0 = 1; }
    else if (fault_count == 4) { f1 = 1; f0 = 0; }
    else if (fault_count == 6) { f1 = 1; f0 = 1; }
    else { /* default to 4 */ f1 = 1; f0 = 0; }

    // Byte1 bits: OS R1 R0 F1 F0 POL TM SD
    // Set R1/R0 to 1/1 (per datasheet converter resolution default),
    // OS=0, POL=0 (active low), TM=0 (comparator), SD=0 (continuous conversion)
    uint8_t cfg_byte1 = 0;
    cfg_byte1 |= (0 << 7); // OS
    cfg_byte1 |= (1 << 6); // R1 (read-only)
    cfg_byte1 |= (1 << 5); // R0 (read-only)
    cfg_byte1 |= (f1 << 4);
    cfg_byte1 |= (f0 << 3);
    cfg_byte1 |= (0 << 2); // POL = 0 -> active low
    cfg_byte1 |= (0 << 1); // TM = 0 -> Comparator mode
    cfg_byte1 |= (0 << 0); // SD = 0 -> continuous conversion

    // Byte2 bits: CR1 CR0 AL EM 0 0 0 0
    // Set CR to 00 for 0.25 Hz (lowest conversion rate) to save power
    // AL is read-only, EM=0 (normal 12-bit mode)
    uint8_t cfg_byte2 = 0;
    cfg_byte2 |= (0 << 7); // CR1
    cfg_byte2 |= (0 << 6); // CR0
    cfg_byte2 |= (0 << 4); // EM = 0

    uint8_t tx_cfg[3];
    tx_cfg[0] = TMP102_REG_CONFIG;
    tx_cfg[1] = cfg_byte1;
    tx_cfg[2] = cfg_byte2;

    ret = HAL_I2C_Master_Transmit(hi2c, TMP102_I2C_ADDRESS, tx_cfg, 3, TMP102_I2C_TIMEOUT_MS);
    if (ret != HAL_OK) {
        return ret;
    }

    // Krátka pauza po zapise konfiguracie
    HAL_Delay(10);

    return HAL_OK;
}
