Orgo2/insuDose/firmware_tests/usb/Drivers/Display/Display_EPD_W21.h

#ifndef _DISPLAY_EPD_W21_H_
#define _DISPLAY_EPD_W21_H_

#include <stdbool.h>
#include <stdint.h>

#define EPD_WIDTH   88 
#define EPD_HEIGHT  184
#define EPD_ARRAY  EPD_WIDTH*EPD_HEIGHT/8  


//Full screen update display
void EPD_HW_Init(void); 
void EPD_HW_Init_180(void);	
void EPD_WhiteScreen_ALL(const unsigned char *datas);
void EPD_WhiteScreen_White(void);
void EPD_WhiteScreen_Black(void);
void EPD_DeepSleep(void);
//Partial update display 
void EPD_SetRAMValue_BaseMap(const unsigned char * datas);
void EPD_Dis_PartAll(const unsigned char * datas);
void EPD_Dis_Part(unsigned int x_start,unsigned int y_start,const unsigned char * datas,unsigned int PART_COLUMN,unsigned int PART_LINE);
void EPD_Dis_Part_Time(unsigned int x_startA,unsigned int y_startA,const unsigned char * datasA,
	                       unsigned int x_startB,unsigned int y_startB,const unsigned char * datasB,
												 unsigned int x_startC,unsigned int y_startC,const unsigned char * datasC,
												 unsigned int x_startD,unsigned int y_startD,const unsigned char * datasD,
											   unsigned int x_startE,unsigned int y_startE,const unsigned char * datasE,
												 unsigned int PART_COLUMN,unsigned int PART_LINE
	                      );	
//Fast update display
void EPD_HW_Init_Fast(void);
void EPD_WhiteScreen_ALL_Fast(const unsigned char *datas);   
//4 Gray update display
void EPD_HW_Init_4Gray(void);
void EPD_WhiteScreen_ALL_4Gray(const unsigned char *datas); 												 
//GUI display					 
void EPD_HW_Init_GUI(void); 
void EPD_Display(unsigned char *Image); 

bool EPD_StartWhiteScreen_White_Async(void);
bool EPD_StartDisplay_Async(const uint8_t *image);
void EPD_AsyncTask(void);
bool EPD_IsAsyncBusy(void);
bool EPD_IsAsyncStop2Safe(void);
												 
#endif
