Orgo2/insuDose/(commit log)

2025-01-18 project updated
    [InsuDos-B_Cu.gbr, InsuDos-B_Fab.gbr, InsuDos-B_Mask.gbr, InsuDos-B_Paste.gbr, InsuDos-B_Silkscreen.gbr, InsuDos-Edge_Cuts.gbr, InsuDos-F_Cu.gbr, InsuDos-F_Fab.gbr]
2025-01-18 old project deleted
    [usb_dn.kicad_pcb, usb_dn.kicad_sch]
2025-06-19 ulozenie po dlhsom case orgiginal epaper display drivre pridane
    [InsuDos_bom.xls]
2025-07-27 added 5v usb detection
    pcb not finished, drc missing, 3d models missing, project needs to be cleaned up
    [InsuDos.kicad_pcb, InsuDos.kicad_sch]
2025-11-01 astest update
    [InsuDos.kicad_sch]
2025-11-01 all messy ackage added
    [InsuDosV2.kicad_pcb, InsuDosV2.kicad_sch, bootloader Debug.cfg]
2025-11-07 uprava kniznic tmp a charger, pridany adcwatchdog na baterku.
2025-11-07 usb descriptor not working but bootloader is, save before gpt update
    [logger.c, main.c, tmp102.c]
