Orgo2/insuDose/(notices)

Notices in the files:
firmware_tests/test_mems/Core/Inc/main.h:
Copyright (c) 2024 STMicroelectronics.
All rights reserved.
firmware_tests/Insudose/Core/Inc/app_conf.h:
Copyright (c) 2025 STMicroelectronics.
